potenciostato/potenciostato/entregable/fotos_en_laboratorio/IMG_20221214_155935435_MFNR.jpg

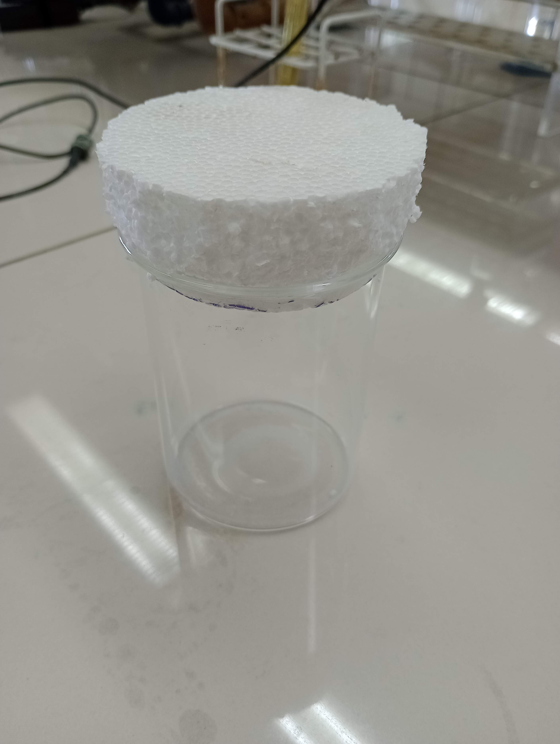
entregable/fotos_en_laboratorio/IMG_20221214_155935435_MFNR.jpg
