potenciostato/potenciostato/entregable/fotos_en_laboratorio/IMG_20221214_183304615_MFNR.jpg

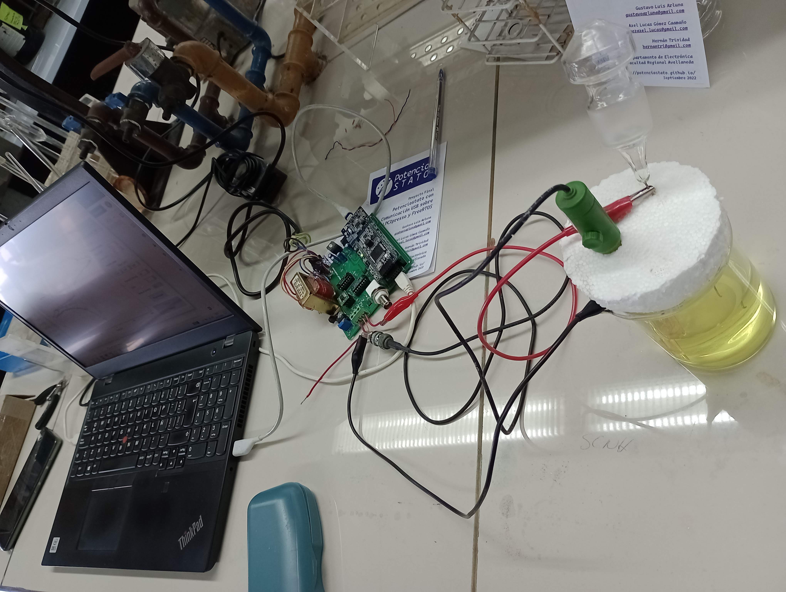
entregable/fotos_en_laboratorio/IMG_20221214_183304615_MFNR.jpg
