potenciostato/potenciostato/README.md

# Potenciostato con comunicación USB sobre LPCXpresso y FreeRTOS

Proyecto Final de la carrera Ingeniería Electrónica de la Universidad Tecnológica Nacional Facultad Regional Avellaneda <br>

El potenciostato es un dispositivo electrónico utilizado en la mayoría de los experimentos electroquímicos.<br>
Es un instrumento capaz de caracterizar la impedancia de una sustancia por medio de la medición de corriente y tensión.<br>

Integrantes del grupo:
- [Arluna, Gustavo Luis](mailto:gustavoarluna@gmail.com)<br>
- [Gómez Caamaño, Axel Lucas](mailto:gomezaxel.lucas@gmail.com)<br>
- [Trinidad, Hernán](mailto:hernantri@gmail.com)<br>

Para más info visitar la [Página Web Oficial](https://potenciostato.github.io) del proyecto
