potenciostato/potenciostato/qt/README.md

# Proyecto Final 2020 - UTN FRA/FRBA: Potenciostato

Mediante la técnica de voltamperometría, se miden sustratos (en principio líquidos) y se los categoriza en función de su respuesta voltamperométrica.

El código del sistema embebido está desarrollado sobre un kit de desarrollo NodeMCU con ESP32. El mismo cuenta con una aplicación web desde la cual se podrá medir y configurar el instrumento.

Integrantes del proyecto:
* Bernal Sebastián
* Gómez Axel
* Trinidad Hernán
* Gustavo Arluna

Links útiles:
* [Trello del proyecto](https://trello.com/b/e63ktGHQ/proyecto-final)
