potenciostato/potenciostato/workspace/periph_timer/example/readme.txt

timer (blinky) example

Example description
This examples uses the timers to generate a periodic interrupt and blink an
LED in the timer interrupt handler.

Special connection requirements
There are no special connection requirements for this example.

Build procedures:
Visit the LPCOpen quickstart guides at link "http://www.lpcware.com/content/project/lpcopen-platform-nxp-lpc-microcontrollers/lpcopen-v200-quickstart-guides"
to get started building LPCOpen projects.
