potenciostato/potenciostato/entregable/Anexo Potenciostato_paper_formato_IEEE_completo.pdf

# Anexo: Potenciostato con Comunicación USB sobre LPCXpresso y FreeRTOS

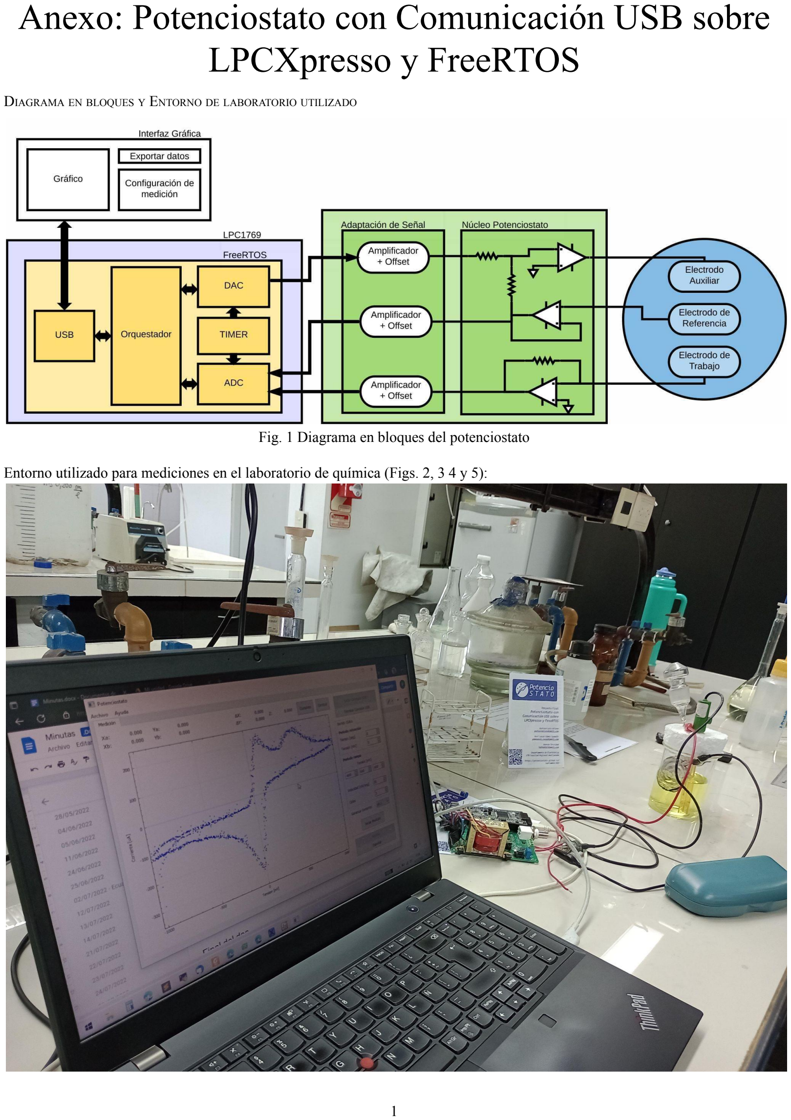
[picture p3: page 1]

DIAGRAMA EN BLOQUES Y ENTORNO DE LABORATORIO UTILIZADO

Fig. 1 Diagrama en bloques del potenciostato

Entorno utilizado para mediciones en el laboratorio de química (Figs. 2, 3 4 y 5):

Fig. 2 Potenciostato con software en Qt en pantalla, recipiente, sustancia y electrodos

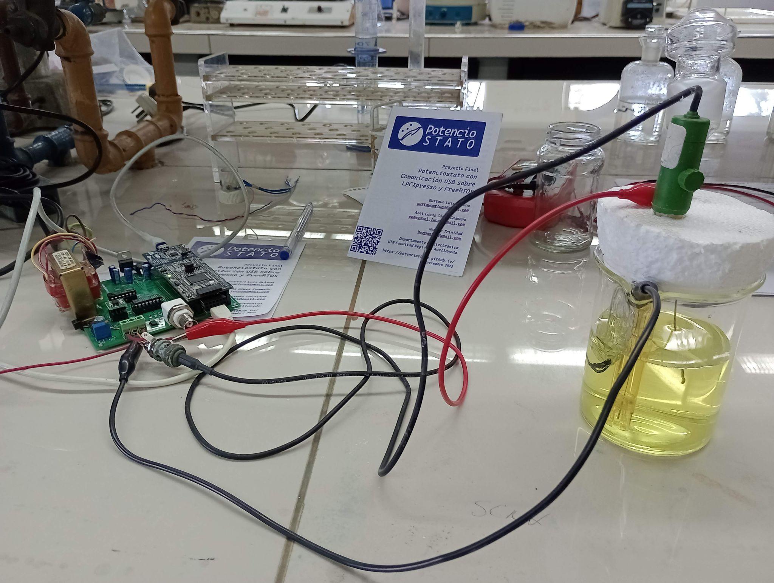
[picture p4: figure]

Fig. 3 Potenciostato con recipiente, sustancia y electrodos

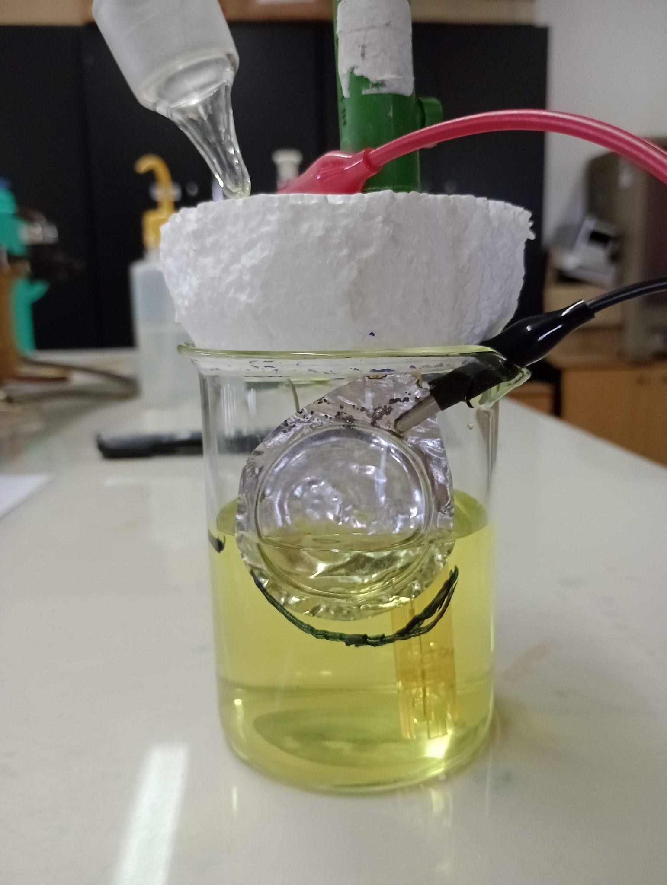
[picture p5: page 3]

Fig. 4 Recipiente con electrodos y sustancia

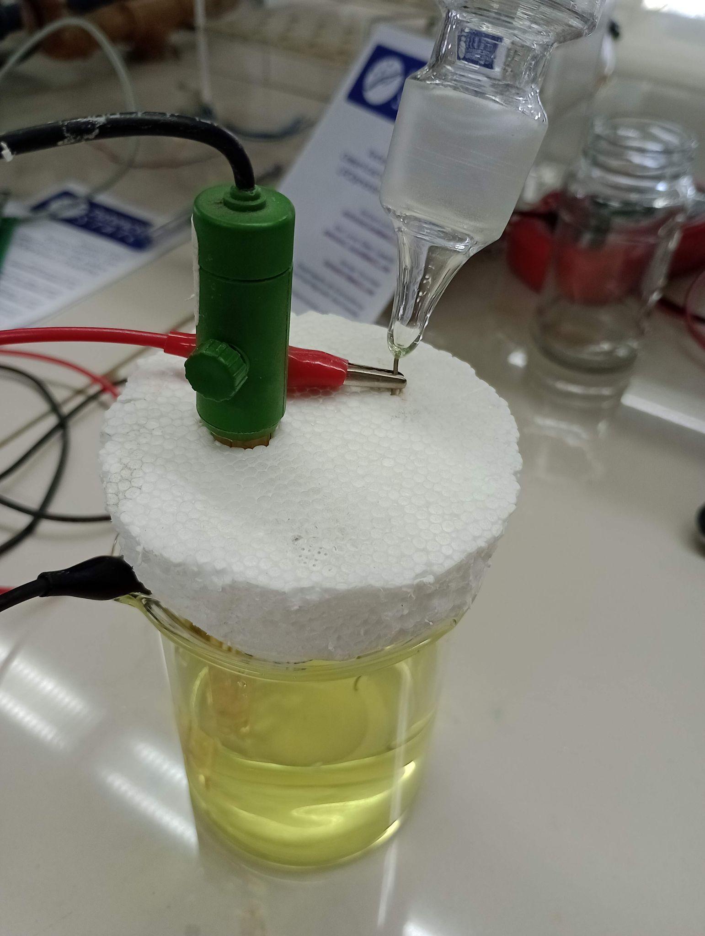
[picture p6: page 4]

Fig. 5 Conexión de los electrodos en recipiente

MEDICIÓN

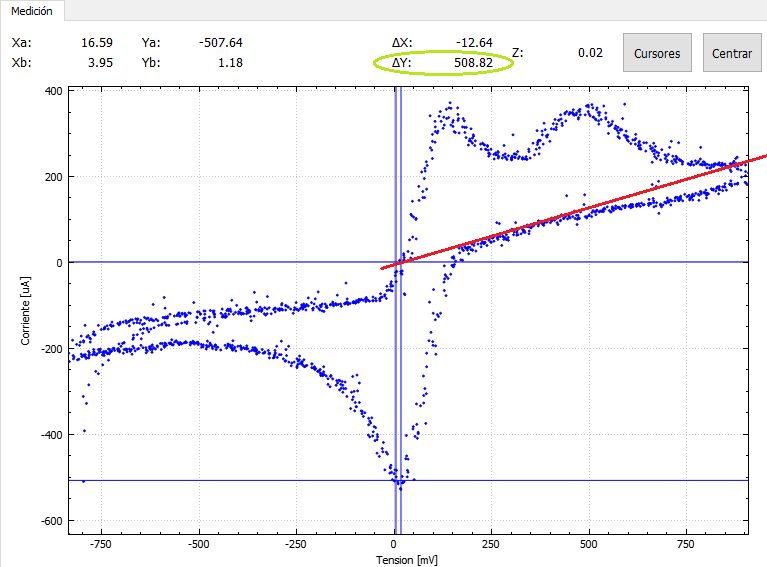
[picture p7: figure]

Fig. 6 Medición realizada por el potenciostato a la mezcla de Ferricianuro de Potasio (5mM), Ferrocianuro de Potasio (5mM) y Cloruro de Potasio (100mM) en un recipiente con electrodos de posición calibrada

HOJA DE CÁLCULOS

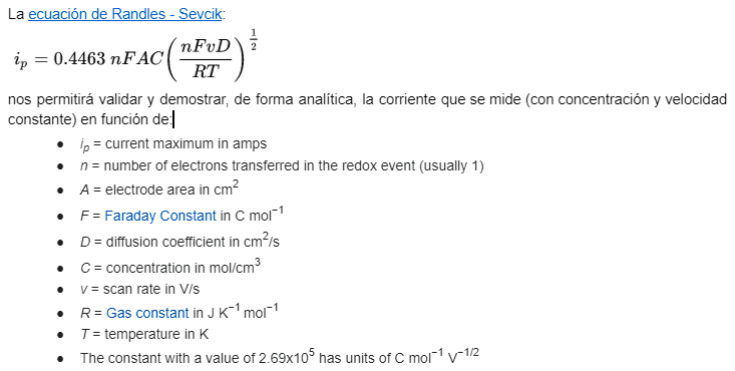
[picture p8: figure]

Ecuación Randles-Sevcik

Ecuación Randles-Sevcik simplificada mediante la cual se puede calcular la constante de difusión:

Datos a utilizar para la ecuación:

Radio electrodo | 0,05 | cm
Altura electrodo | 2 | cm
n (electrones transferidos) | 1 | sin unidad
F = Faraday Constant in C mol−1 | 96485,33212 | C * mol^(−1)
A = electrode area in cm2 | 0,6361725124 | cm^2
C = concentration in mol/cm3 | 0,005 | M
ν = scan rate in V/s | 0,05 | V/s
R = Gas constant in J K−1 mol−1 | 8,31432 | J*K^(-1)*mol^(-1)
T = temperature in K | 300 | K

Nota: las constantes de Faraday y de los gases junto con la temperatura (25°C ó 300K) están incluídas en la ecuación simplificada a utilizar.

Corriente medida:

ip | 0,508 | mA

Resultado obtenido:

D | 7,11E-06 | cm^2 / s

Resultado ideal (se puede demostrar teóricamente):

D = diffusion coefficient in cm2/s | 0,000007 | cm^2 / s

Constante de difusión obtenida: 7,11.E-06
Constante de difusión verdadera: 7.E-06 => Er = 1,6%

IEC 61010:2010 - REQUERIMIENTOS PARA EQUIPAMIENTO ELÉCTRICO PARA MEDICIÓN, CONTROL Y USO EN LABORATORIOS
Marco Regulatorio, Legal y Normativo
Todos los aparatos eléctricos de uso comercial, doméstico, accesibles al público en general, deben cumplir con los requisitos de la Resolución 162/2018, que exige que dichos productos cumplan con normas de seguridad eléctrica y posean cierta información que permita hacer un uso seguro del mismo, de manera de evitar accidentes, pérdidas materiales, económicas y humanas.

Los productos dentro del alcance de la Resolución 162/2018 son todos aquellos que tengan una tensión nominal de hasta 1.000V en valor eficaz de corriente alterna senoidal o hasta 1.500V en corriente continua. A estos aparatos se los denomina “equipamientos eléctricos de baja tensión” y deben ser ensayados bajo normas IRAM o IEC. En la mayoría de los casos, se utilizan las normas internacionales IEC debido a que las normas locales IRAM no han sido actualizadas en los últimos años.

Sin embargo, hay determinados productos que están exentos de cumplir obligatoriamente con los requerimientos de la Resolución 162/2018. Los artículos 12 y 13 de la Resolución establecen las condiciones para considerar que un aparato eléctrico queda exento del cumplimiento de la misma. Una de esas condiciones es que el “equipamiento que por sus características técnicas sea de uso profesional, o por ser destinado a incorporarse a procesos en los que serán operados por personal capacitado en materia de seguridad eléctrica, o bien siendo estos bienes instalados únicamente por personal idóneo y destinados a usos profesionales por parte de operadores con conocimientos en dicha materia” puede comercializarse respaldado por una declaración jurada del fabricante nacional o importador.

En el caso del potenciostato, se considera que está destinado a ser utilizado por personal capacitado de laboratorio que se encuentra fuera del alcance del acceso al público en general.

Por tal motivo, no es obligación ensayar el potenciostato bajo las normas de seguridad para comercializarlo en el país.

Sin embargo, siempre es posible ensayar de manera voluntaria el potenciostato bajo la norma IEC: 61010-1:2010, en especial si se fabrica con fines de exportación, ya que en otros países la certificación podría ser obligatoria.

### L7805GND

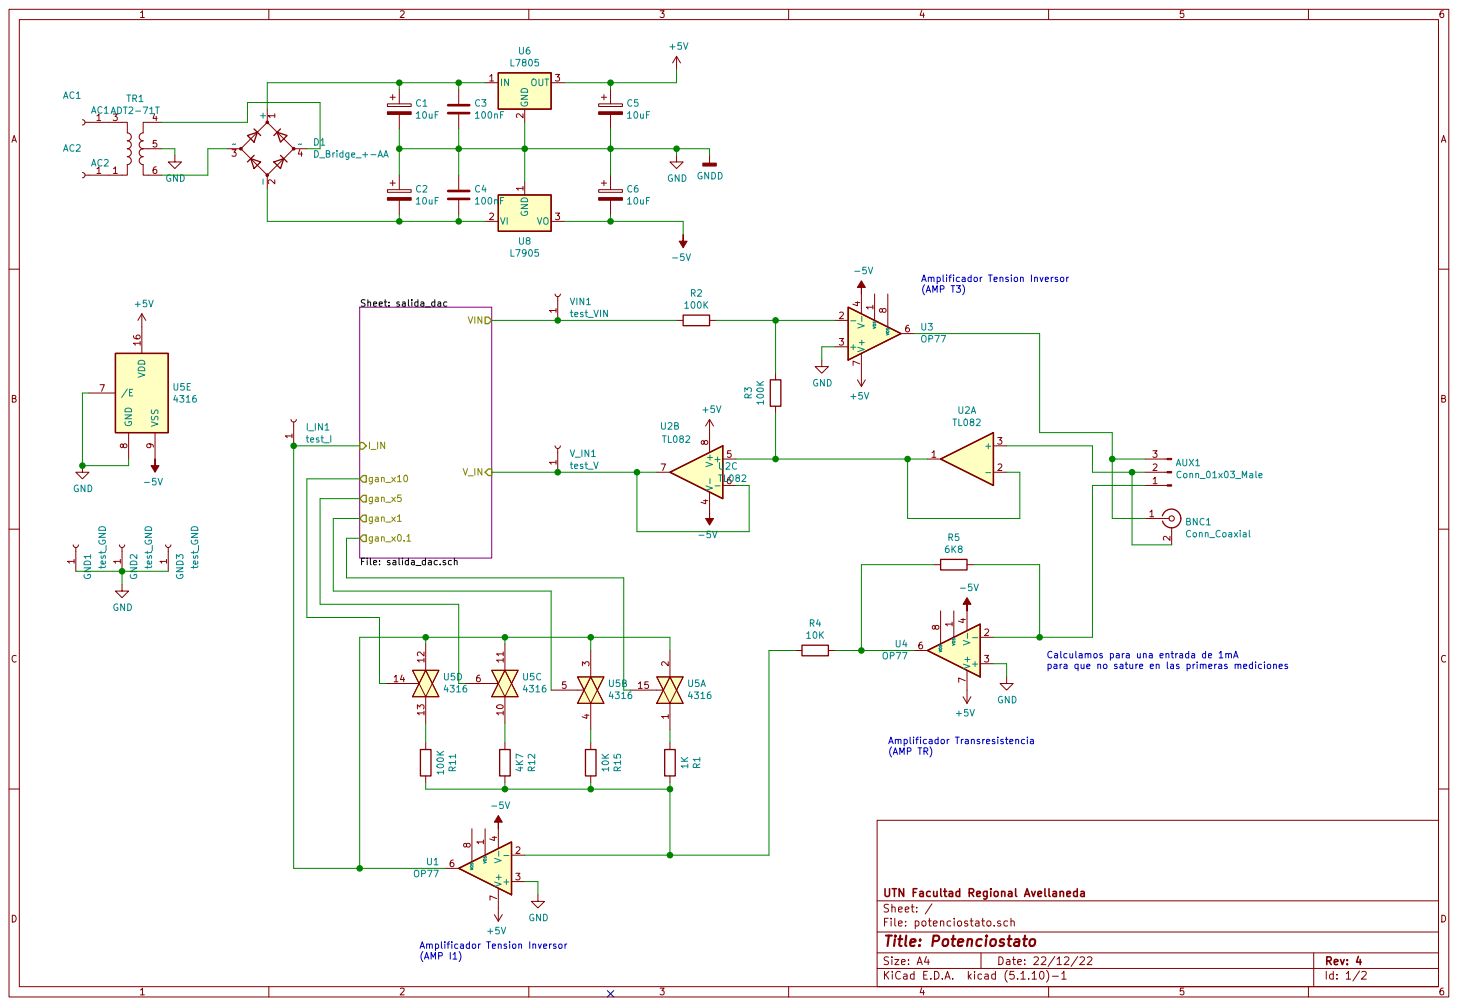
[picture p9: page 8]

Calculamos para una entrada de 1mA
para que no sature en las primeras mediciones

File: potenciostato.sch Sheet: / UTN Facultad Regional Avellaneda

### TL064 R9

# (AMP I2) Salida DAC uC de 0 a 3.3V

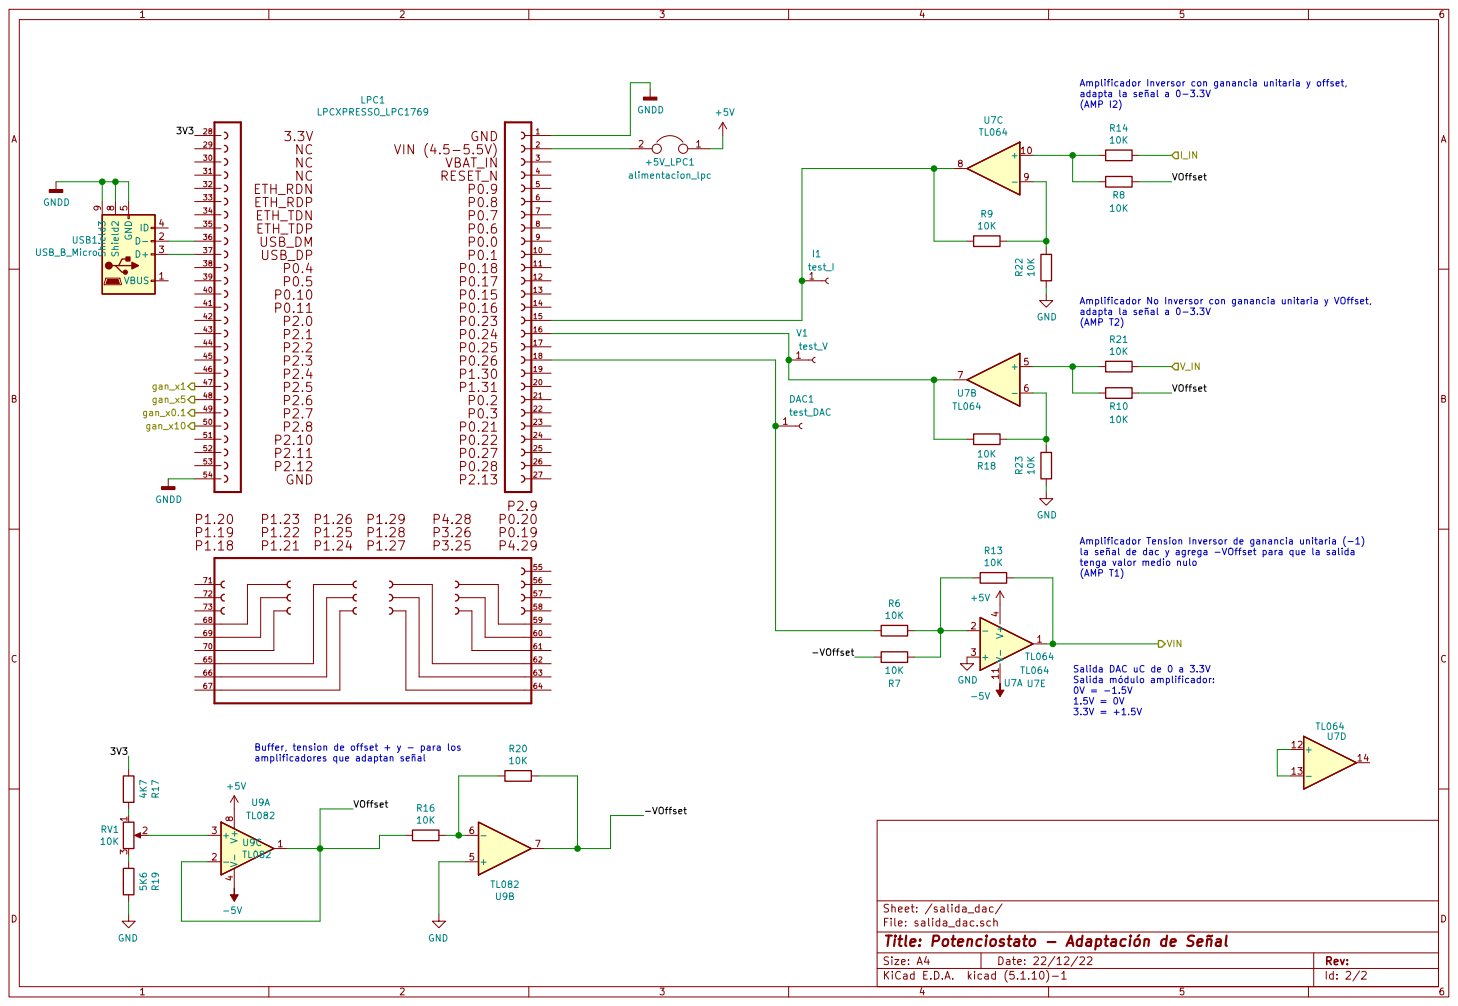
[picture p10: page 9]

Amplificador Inversor con ganancia unitaria y offset,
adapta la señal a 0-3.3V

Amplificador No Inversor con ganancia unitaria y VOffset,
(AMP T2)

Amplificador Tension Inversor de ganancia unitaria (-1)

la señal de dac y agrega -VOffset para que la salida
tenga valor medio nulo
(AMP T1)

Buffer, tension de offset + y - para los
amplificadores que adaptan señal

File: salida_dac.sch
Id: 2/2 Title: Potenciostato - Adaptación de Señal

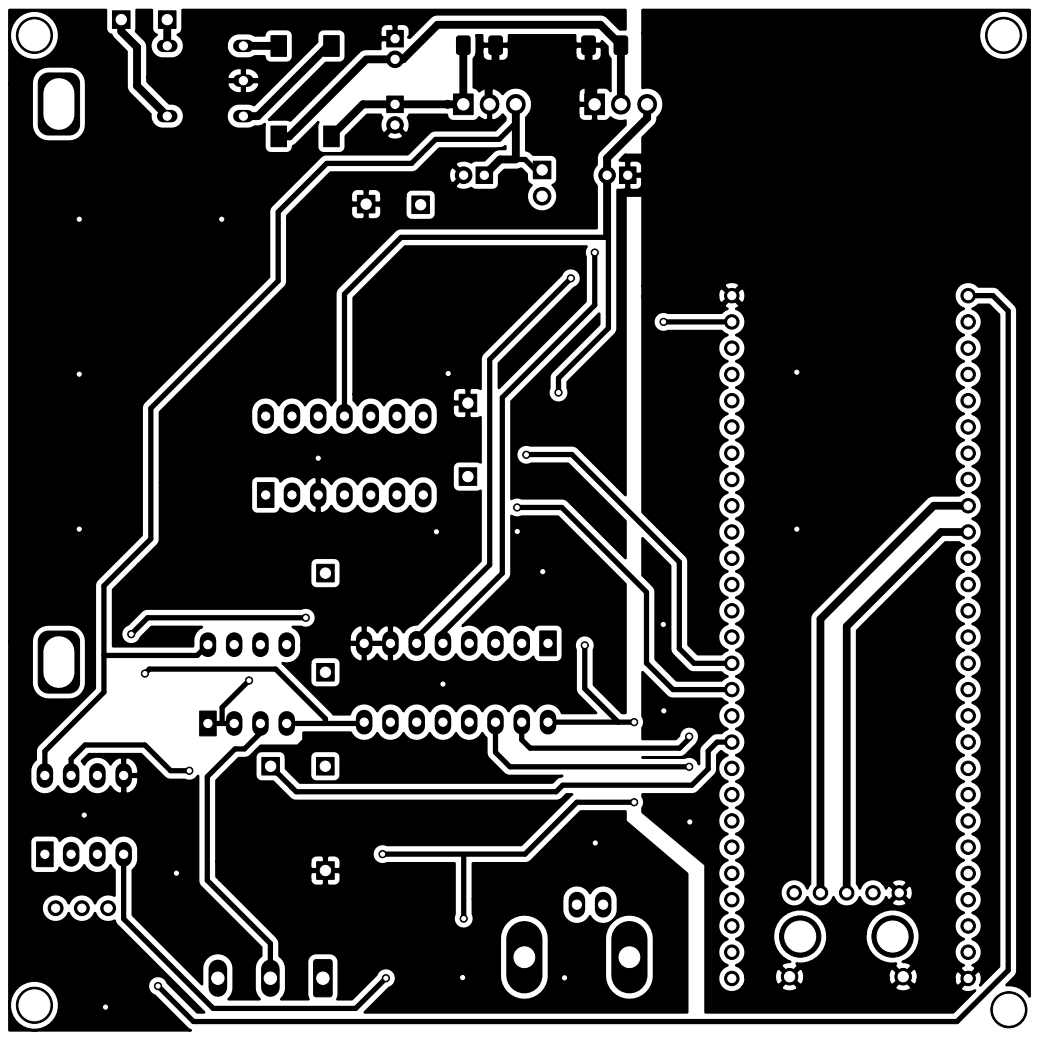
[picture p11: page 10]

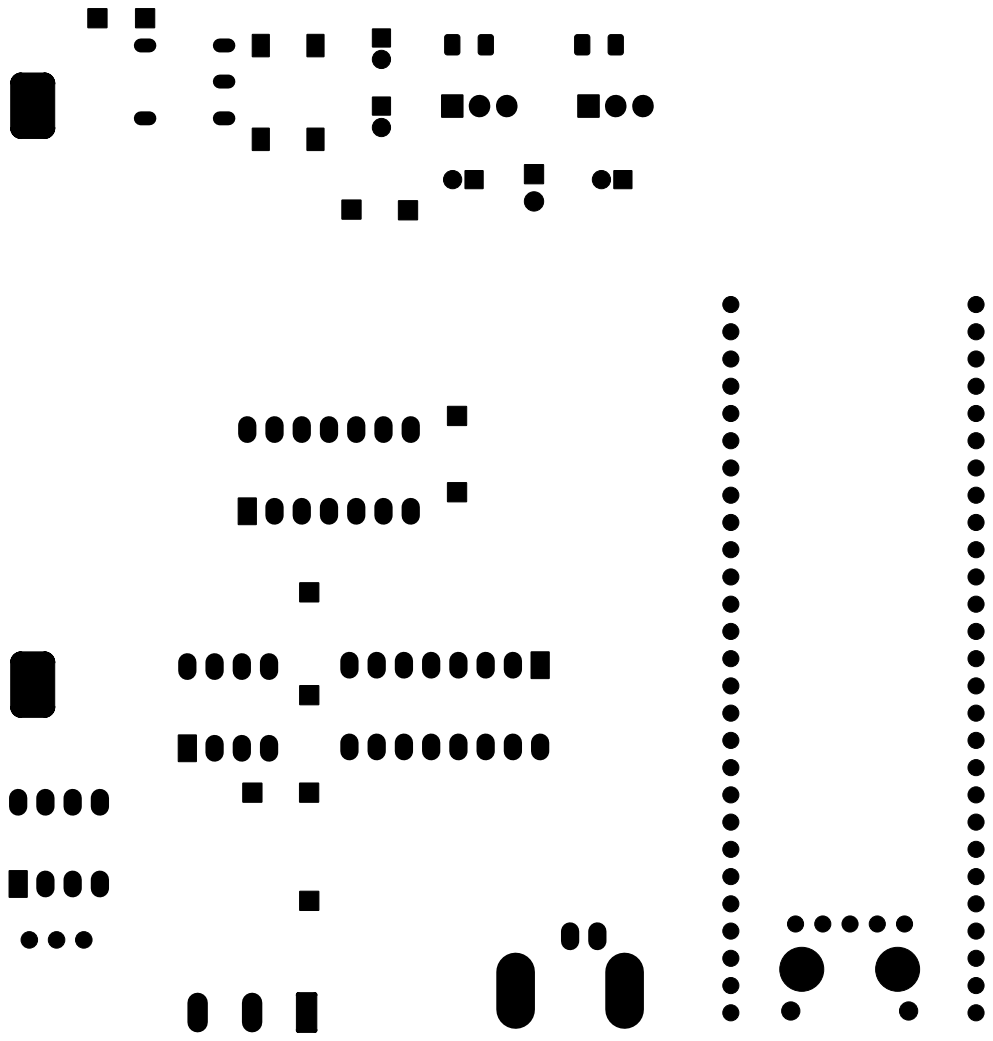
[picture p12: page 11]

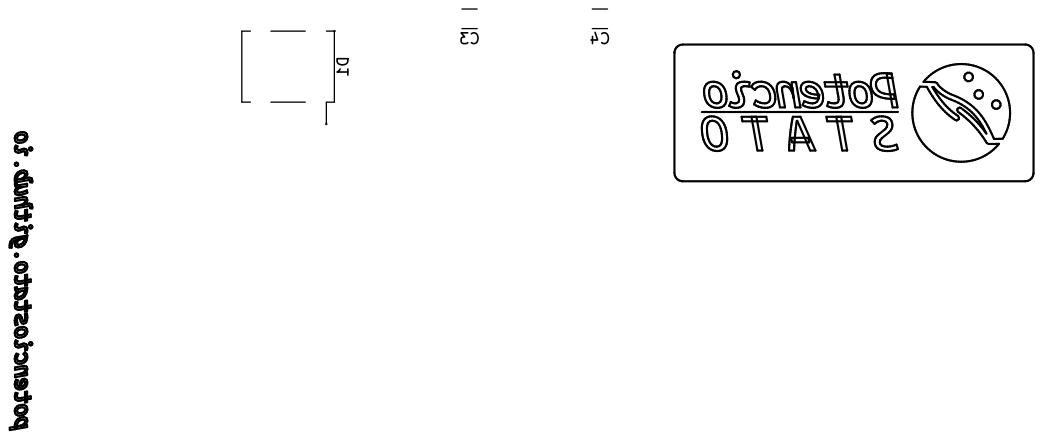
[picture p13: page 12]

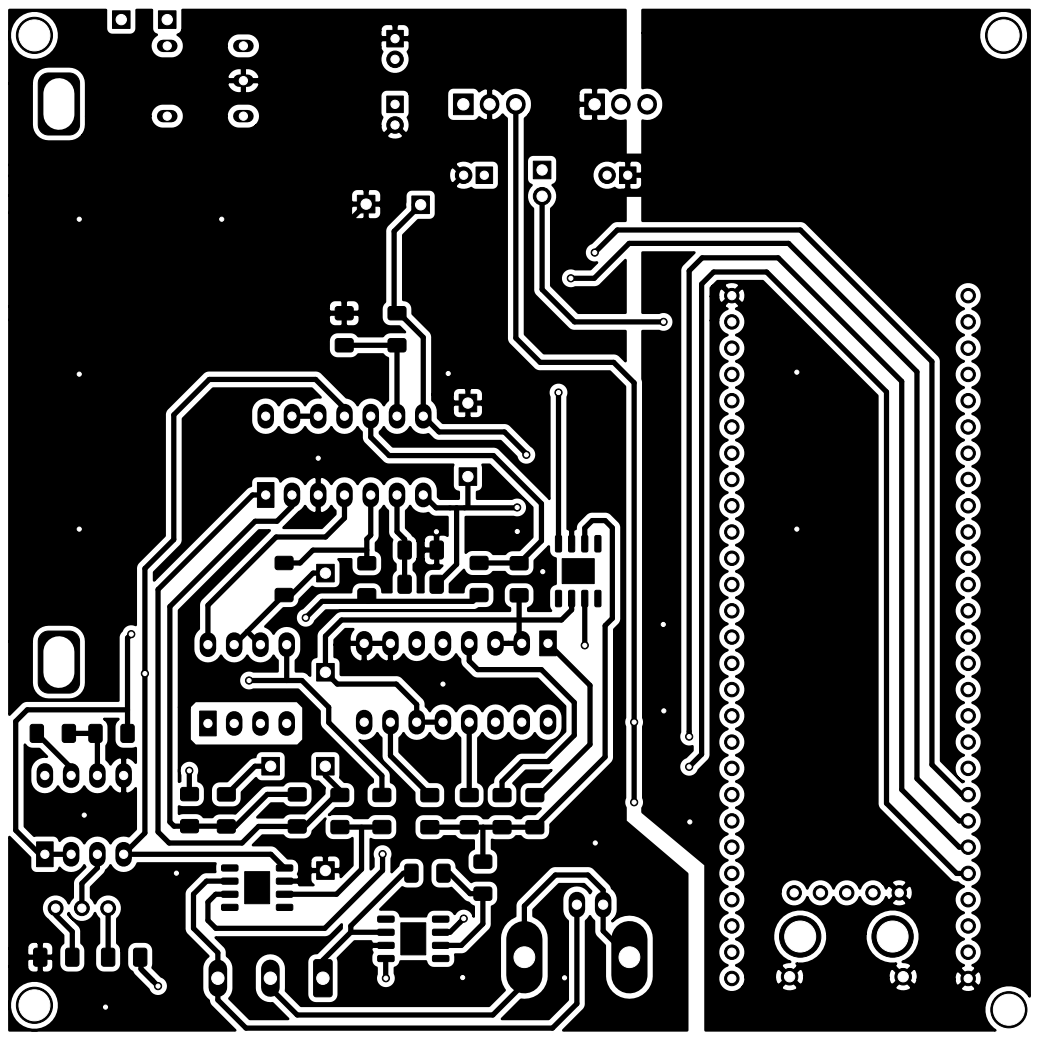
[picture p14: page 13]

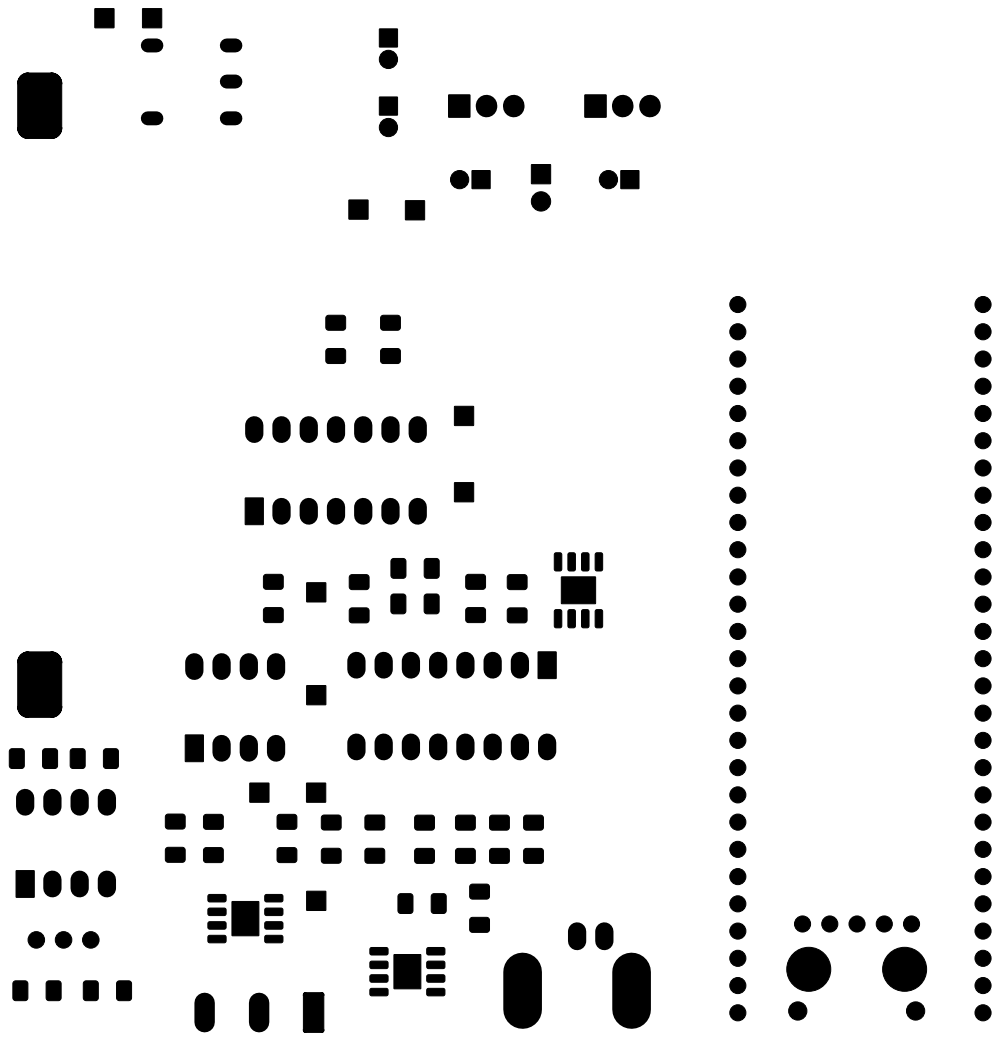
[picture p15: page 14]

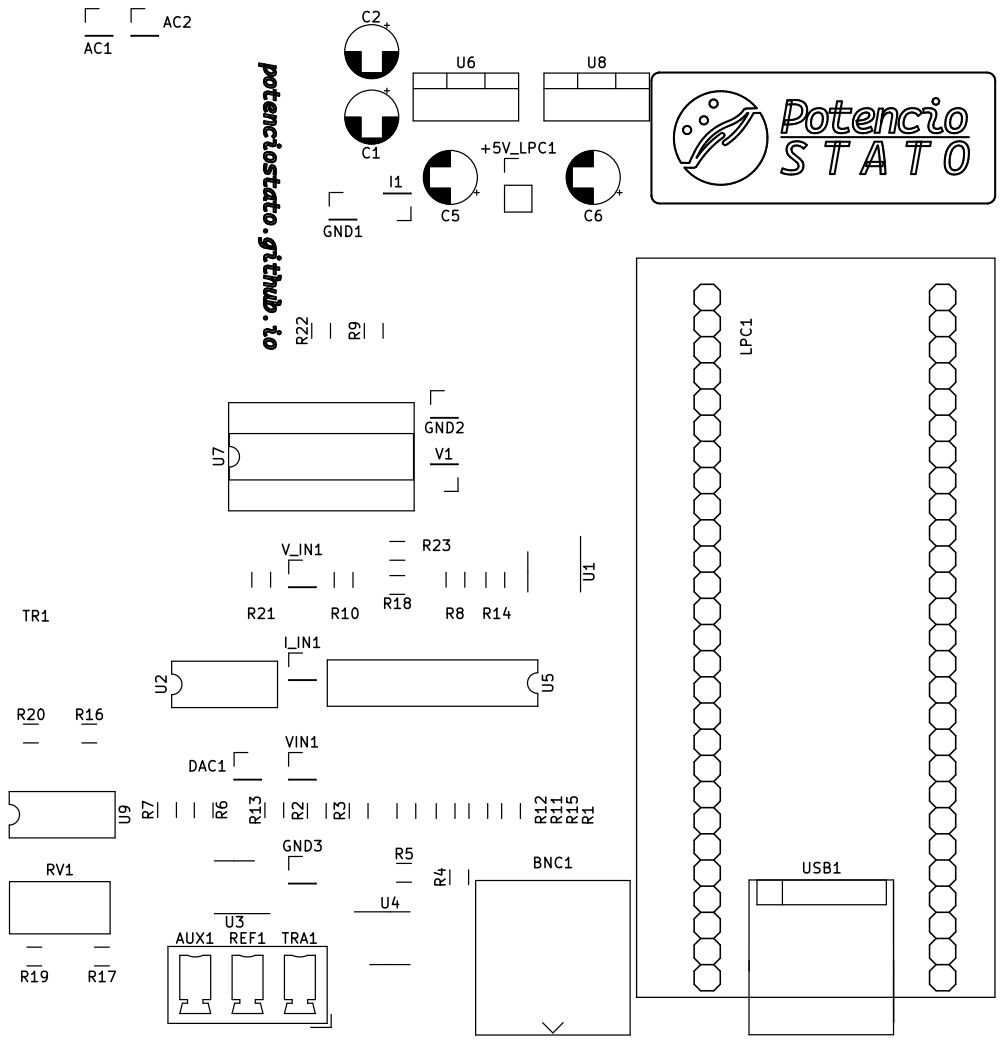
[picture p16: page 15]
