potenciostato/potenciostato/entregable/fotos_en_laboratorio/IMG_20221214_175959559_MFNR.jpg

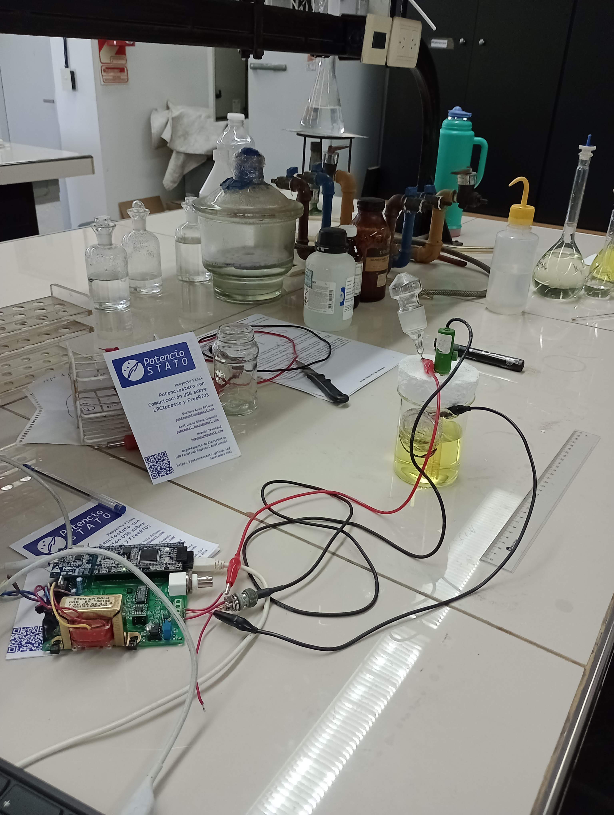
entregable/fotos_en_laboratorio/IMG_20221214_175959559_MFNR.jpg
