potenciostato/potenciostato/entregable/fotos_en_laboratorio/IMG_20221214_180008440_MFNR.jpg

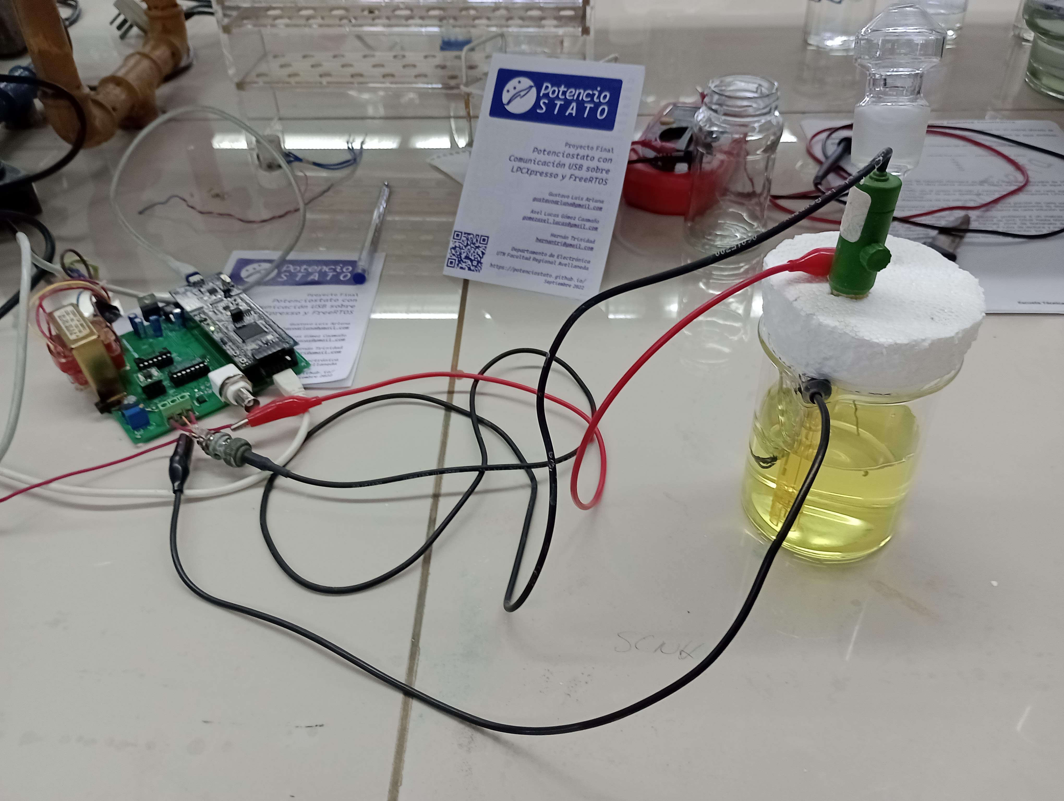
entregable/fotos_en_laboratorio/IMG_20221214_180008440_MFNR.jpg
