potenciostato/potenciostato/entregable/fotos_en_laboratorio/IMG_20221214_180010219_MFNR.jpg

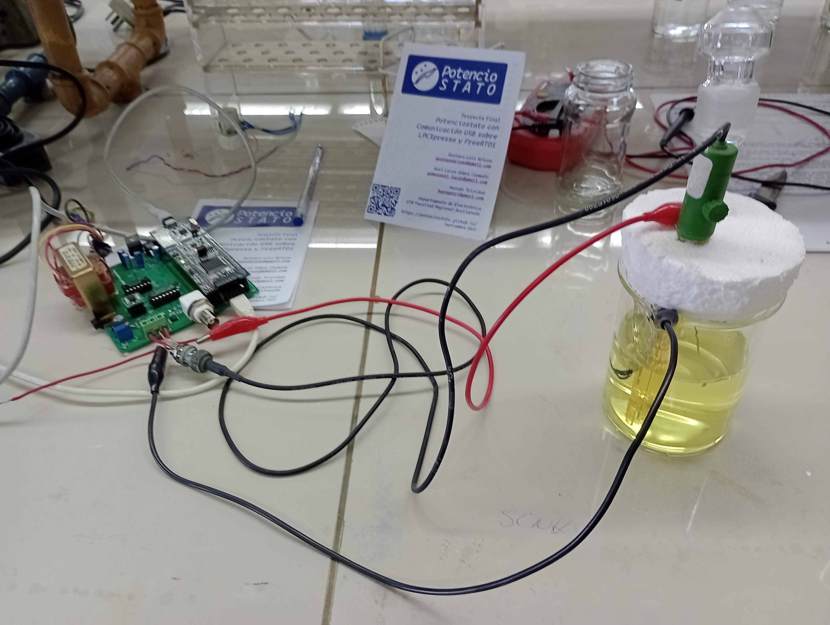
entregable/fotos_en_laboratorio/IMG_20221214_180010219_MFNR.jpg
