potenciostato/potenciostato/entregable/fotos_en_laboratorio/IMG_20221214_184859711.jpg

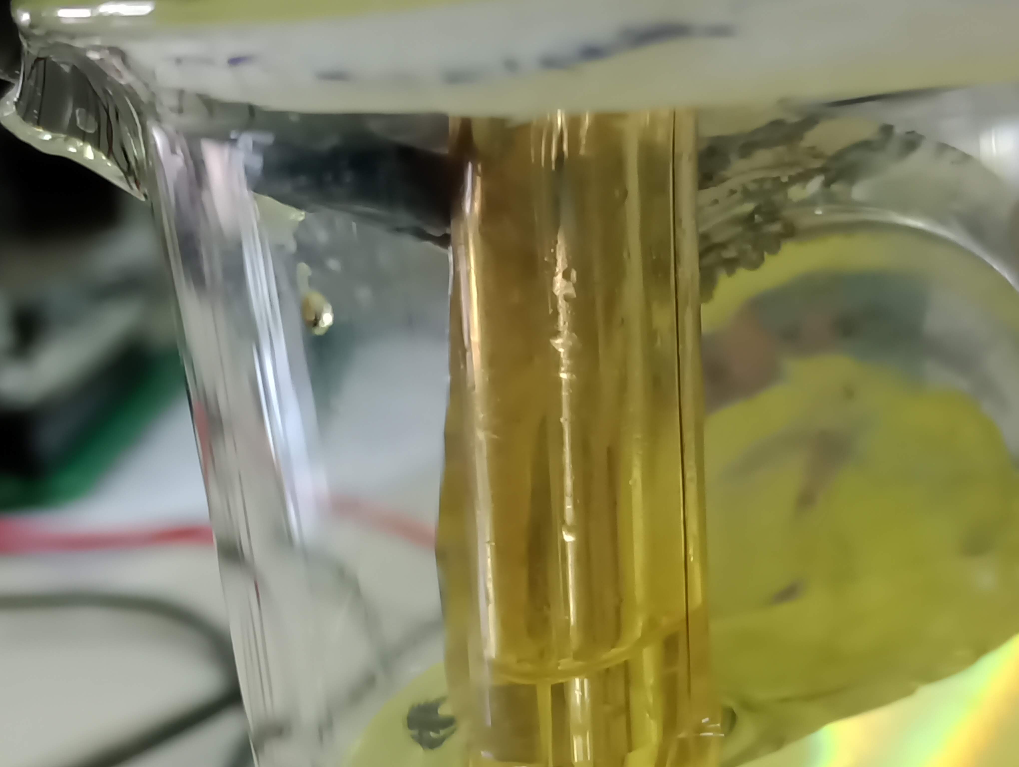
entregable/fotos_en_laboratorio/IMG_20221214_184859711.jpg
