potenciostato/potenciostato/entregable/fotos_en_laboratorio/IMG_20221214_184909411.jpg

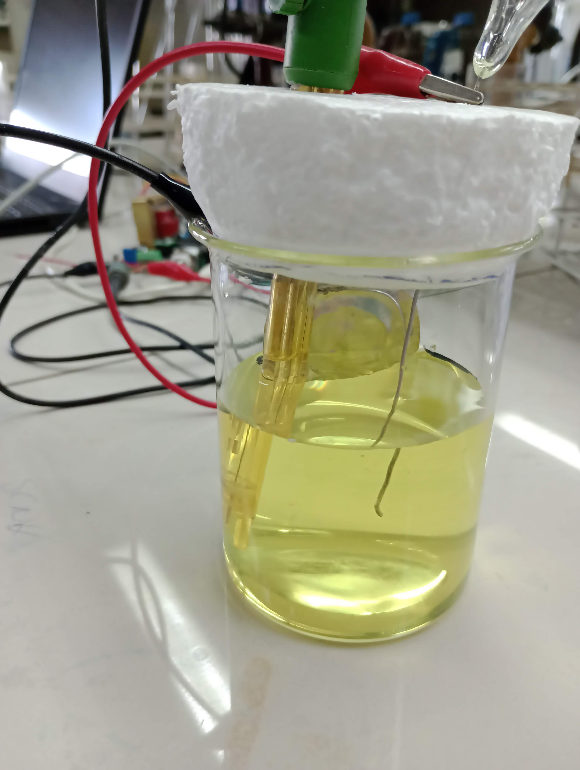
entregable/fotos_en_laboratorio/IMG_20221214_184909411.jpg
