potenciostato/potenciostato/ltspice/20200818_140919.jpg

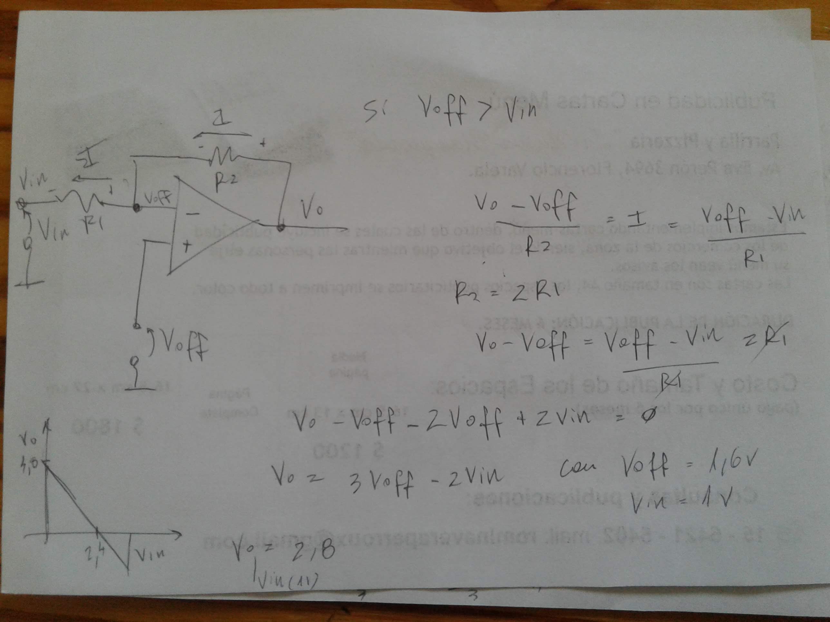
ltspice/20200818_140919.jpg
