potenciostato/potenciostato/ltspice/20200818_140930.jpg

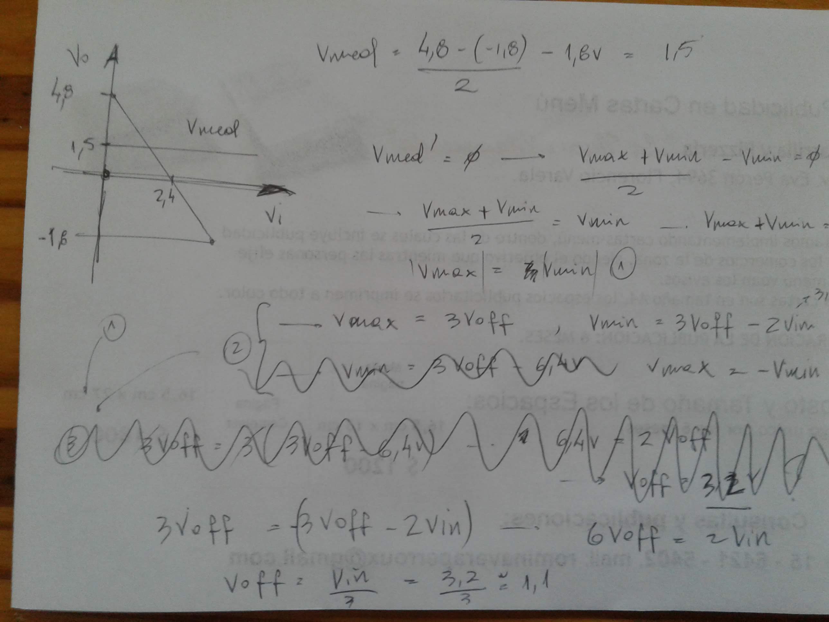
ltspice/20200818_140930.jpg
