potenciostato/potenciostato/ltspice/20200818_142315.jpg

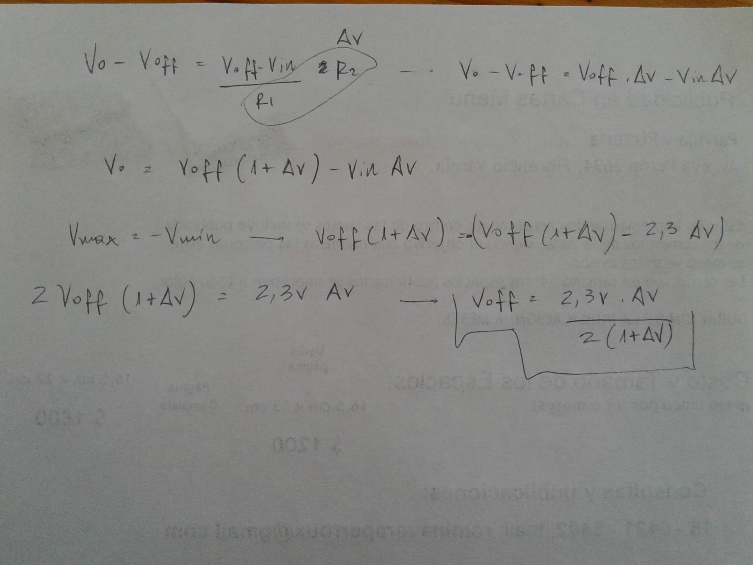
ltspice/20200818_142315.jpg
