potenciostato/potenciostato/logo/logo_potencio_kicad_web_invertida.dxf

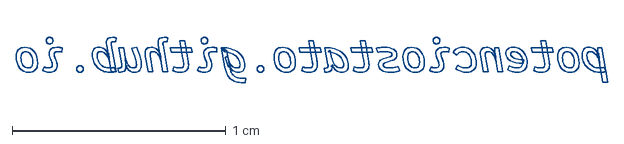
[picture p48: CAD file, 2022-11-13]
logo/logo_potencio_kicad_web_invertida.dxf
2.77 x 0.212 cm
