potenciostato/potenciostato/logo/logo_potencio_kicad_web.dxf

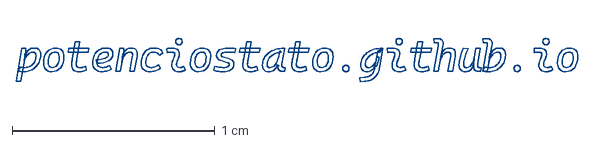
[picture p49: CAD file, 2022-11-13]
logo/logo_potencio_kicad_web.dxf
2.77 x 0.212 cm
