potenciostato/potenciostato/logo/logo_potencio_kicad_invertido.dxf

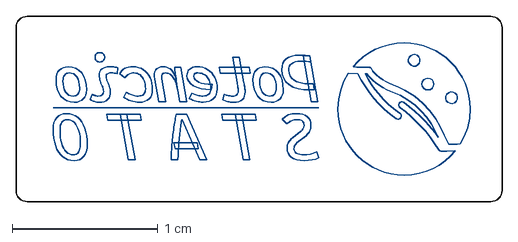
[picture p50: CAD file, 2022-11-11]
logo/logo_potencio_kicad_invertido.dxf
3.34 x 1.27 cm
