potenciostato/potenciostato/logo/qr.dxf

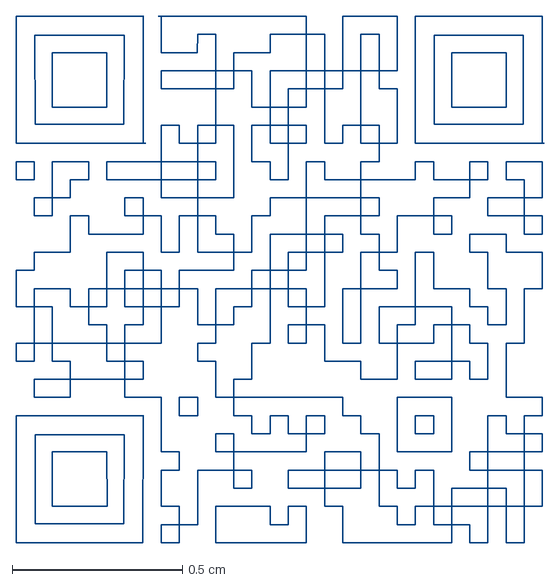
[picture p51: CAD file, 2022-11-11]
logo/qr.dxf
1.55 x 1.55 cm
