potenciostato/potenciostato/logo/logo_potencio.dxf

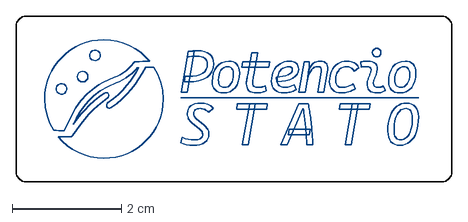
[picture p52: CAD file, 2022-11-11]
logo/logo_potencio.dxf
7.99 x 3.04 cm
