potenciostato/potenciostato/csv/med_2022.12.14-18_26_06_recalibrado_x0.1.csv

Tension | Corriente
27.515 | -75.220
26.027 | -73.056
-835.489 | -632.593
-803.498 | -633.674
-796.803 | -510.295
-794.571 | -392.327
-789.363 | -328.472
-797.547 | -312.238
-783.411 | -285.182
-758.861 | -259.206
-765.557 | -253.796
-747.701 | -238.643
-732.822 | -227.820
-743.981 | -216.999
-744.725 | -207.257
-729.846 | -202.929
-718.687 | -199.683
-700.831 | -195.353
-692.648 | -186.695
-706.039 | -189.941
-693.392 | -187.777
-668.840 | -169.378
-662.888 | -131.499
-668.840 | -175.872
-659.168 | -168.296
-645.033 | -165.049
-629.410 | -161.802
-650.985 | -156.391
-633.129 | -156.391
-624.202 | -155.309
-616.018 | -152.062
-604.115 | -146.650
-595.188 | -143.404
-596.675 | -145.568
-578.076 | -146.650
-584.772 | -145.568
-584.028 | -146.650
-558.733 | -144.486
-555.013 | -143.404
-531.206 | -137.992
-537.158 | -139.074
-531.950 | -142.321
-545.341 | -141.239
-505.167 | -128.252
-514.095 | -93.619
-508.887 | -140.157
-487.312 | -134.745
-485.080 | -129.334
-488.799 | -130.416
-472.432 | -139.074
-473.921 | -127.169
-460.528 | -127.169
-439.698 | -122.840
-438.954 | -127.169
-441.186 | -127.169
-430.026 | -126.087
-432.258 | -123.923
-424.074 | -120.676
-412.171 | -120.676
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
