potenciostato/potenciostato/csv/med_2022.12.14-18_26_06_recalibrado_x1.csv

Tension | Corriente
27.515 | -7.522
26.027 | -7.306
-835.489 | -63.259
-803.498 | -63.367
-796.803 | -51.030
-794.571 | -39.233
-789.363 | -32.847
-797.547 | -31.224
-783.411 | -28.518
-758.861 | -25.921
-765.557 | -25.380
-747.701 | -23.864
-732.822 | -22.782
-743.981 | -21.700
-744.725 | -20.726
-729.846 | -20.293
-718.687 | -19.968
-700.831 | -19.535
-692.648 | -18.669
-706.039 | -18.994
-693.392 | -18.778
-668.840 | -16.938
-662.888 | -13.150
-668.840 | -17.587
-659.168 | -16.830
-645.033 | -16.505
-629.410 | -16.180
-650.985 | -15.639
-633.129 | -15.639
-624.202 | -15.531
-616.018 | -15.206
-604.115 | -14.665
-595.188 | -14.340
-596.675 | -14.557
-578.076 | -14.665
-584.772 | -14.557
-584.028 | -14.665
-558.733 | -14.449
-555.013 | -14.340
-531.206 | -13.799
-537.158 | -13.907
-531.950 | -14.232
-545.341 | -14.124
-505.167 | -12.825
-514.095 | -9.362
-508.887 | -14.016
-487.312 | -13.475
-485.080 | -12.933
-488.799 | -13.042
-472.432 | -13.907
-473.921 | -12.717
-460.528 | -12.717
-439.698 | -12.284
-438.954 | -12.717
-441.186 | -12.717
-430.026 | -12.609
-432.258 | -12.392
-424.074 | -12.068
-412.171 | -12.068
-399.523 | -11.959
-392.084 | -12.068
-386.132 | -11.959
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
