potenciostato/potenciostato/kicadv2/potencio_IMPRIMIR.pdf

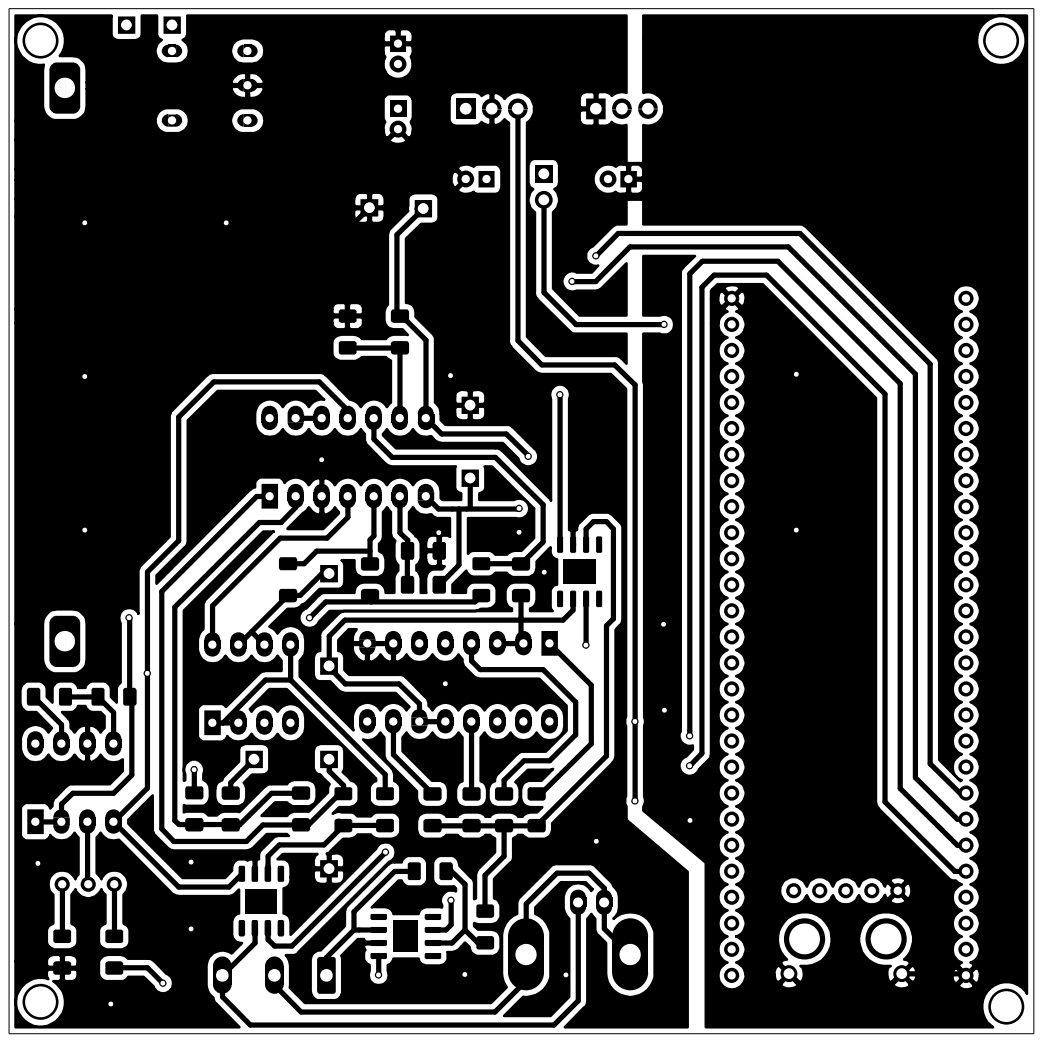
[picture p53: page 1]

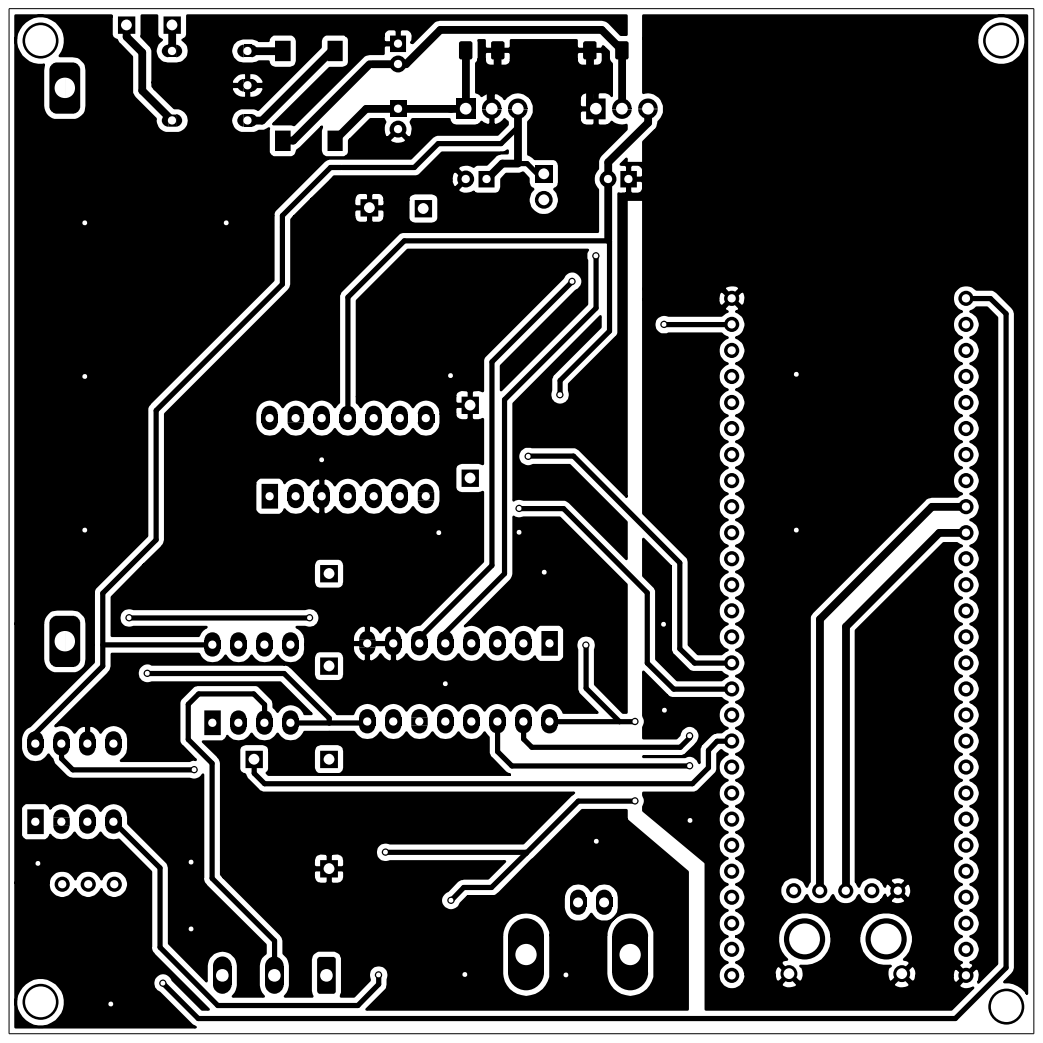
[picture p54: page 2]
