potenciostato/potenciostato/logo/Potenciostato.pdf

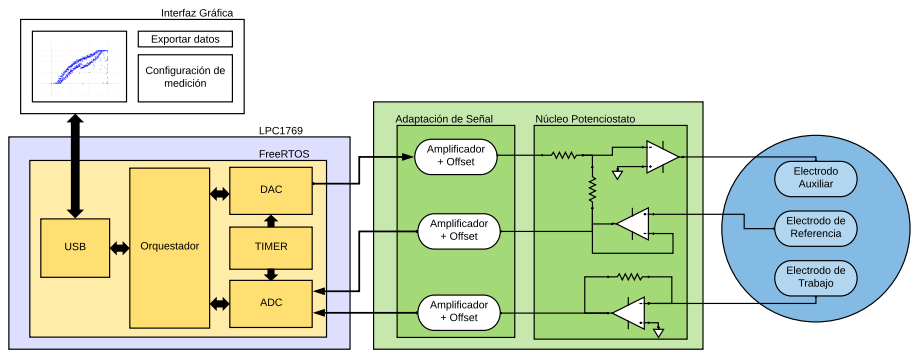
[picture p55: page 1]
fic; fig; ció; dició; plific; Ele; xilia; cia; ajo; cle; cio; s Interfaz Gráfic; TIM
