potenciostato/potenciostato/kicad_reducido/potenciostato-B_Cu.pdf

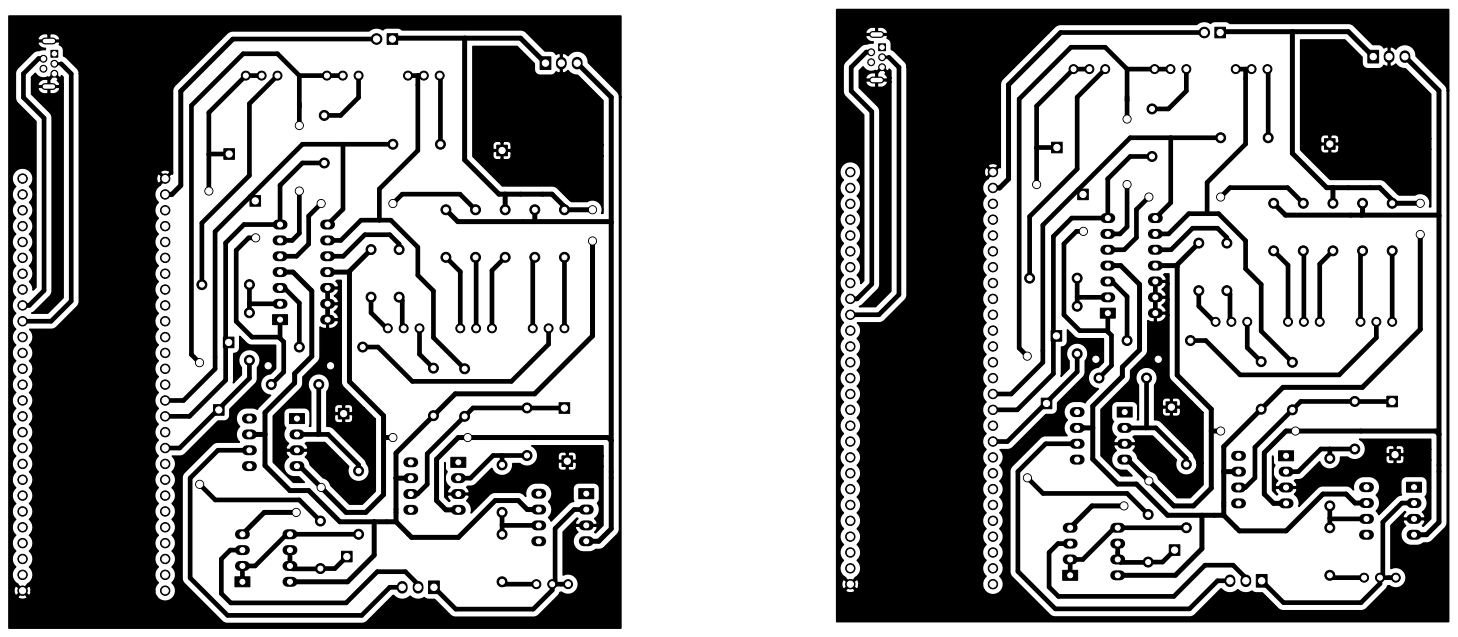
[picture p60: page 1]
