potenciostato/potenciostato/kicad_reducido/potenciostato_v0.pdf

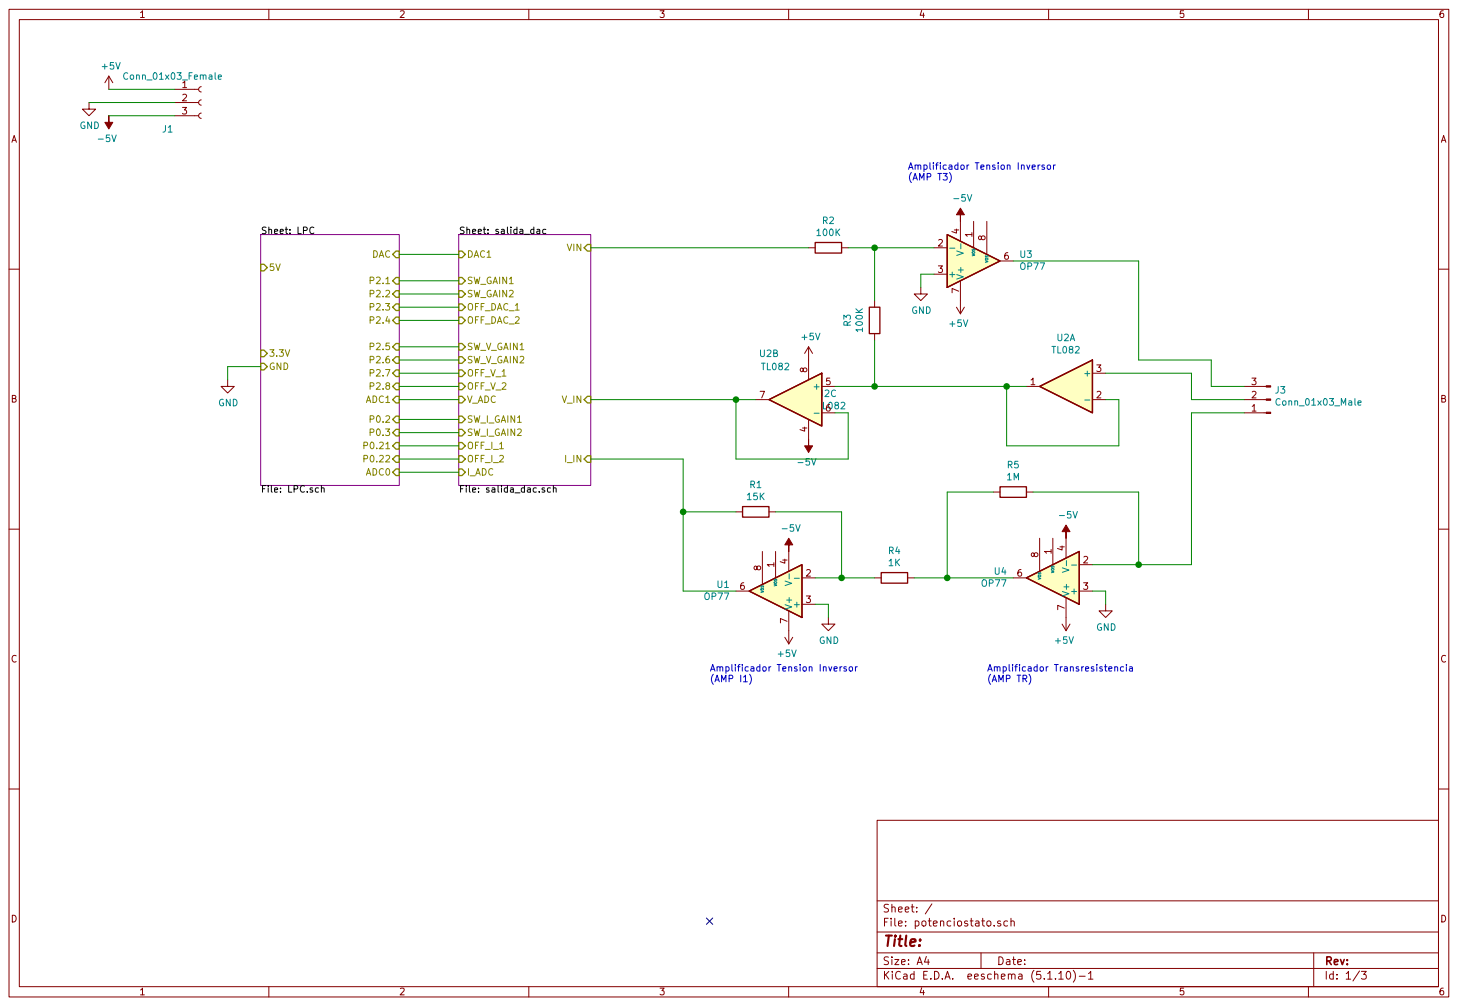
[picture p61: page 1]

File: LPC.sch GND

File: potenciostato.sch Sheet: /
Id: 1/3 Title:

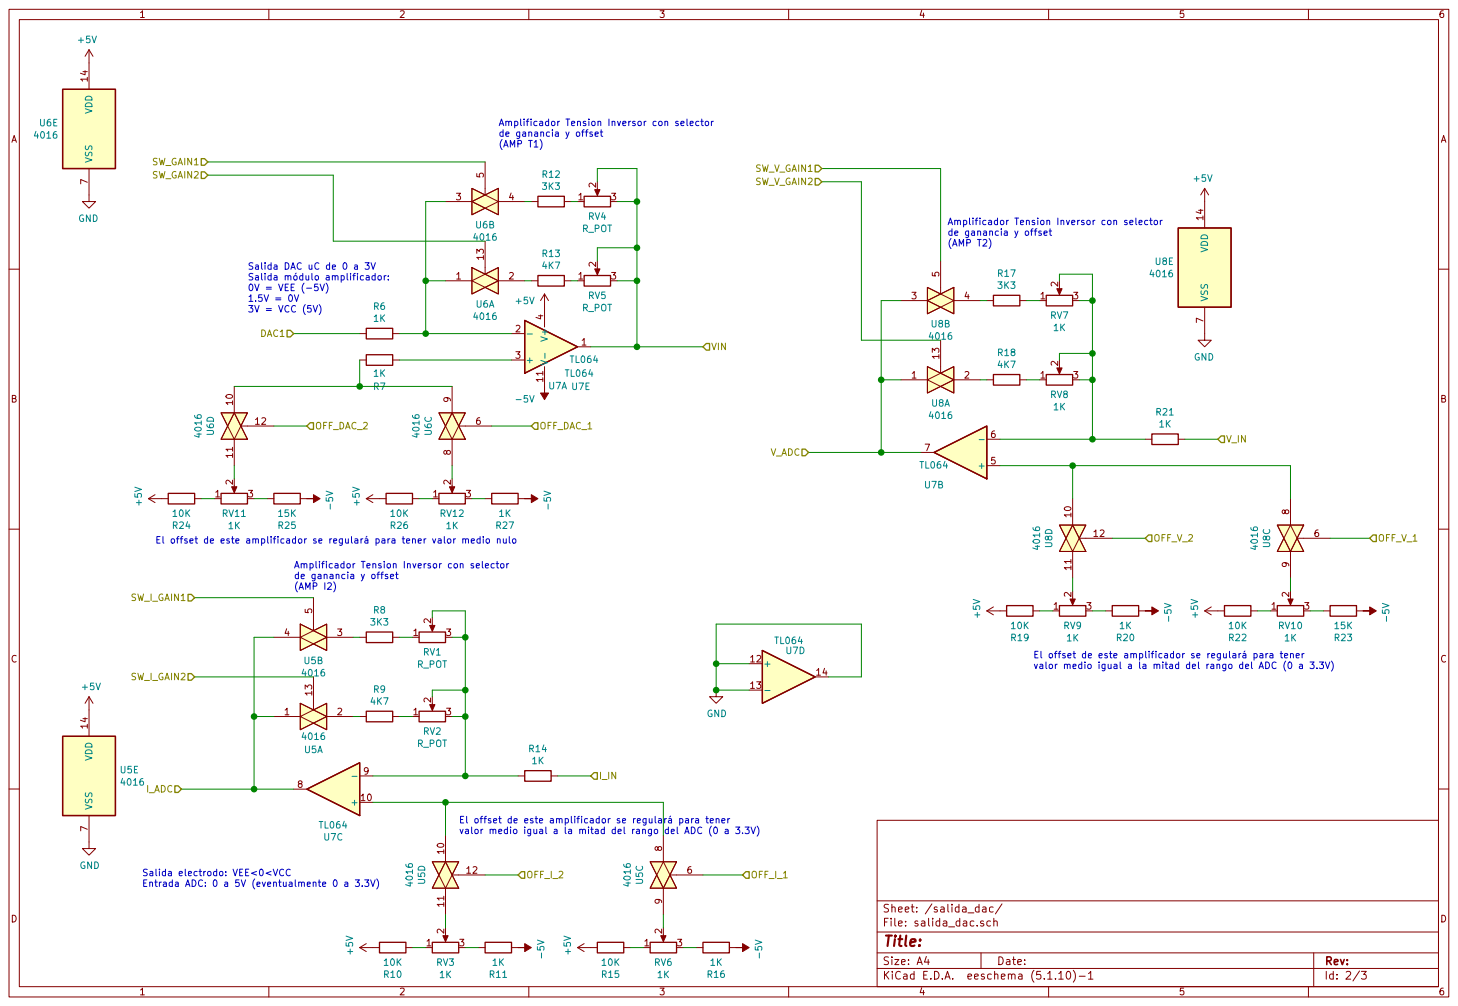
[picture p62: page 2]

Amplificador Tension Inversor con selector
de ganancia y offset
(AMP T1)

(AMP T2)

valor medio igual a la mitad del rango del ADC (0 a 3.3V) Salida DAC uC de 0 a 3V
Salida módulo amplificador:
0V = VEE (-5V) 1.5V = 0V

El offset de este amplificador se regulará para tener valor medio nulo

(AMP I2)

El offset de este amplificador se regulará para tener

valor medio igual a la mitad del rango del ADC (0 a 3.3V)

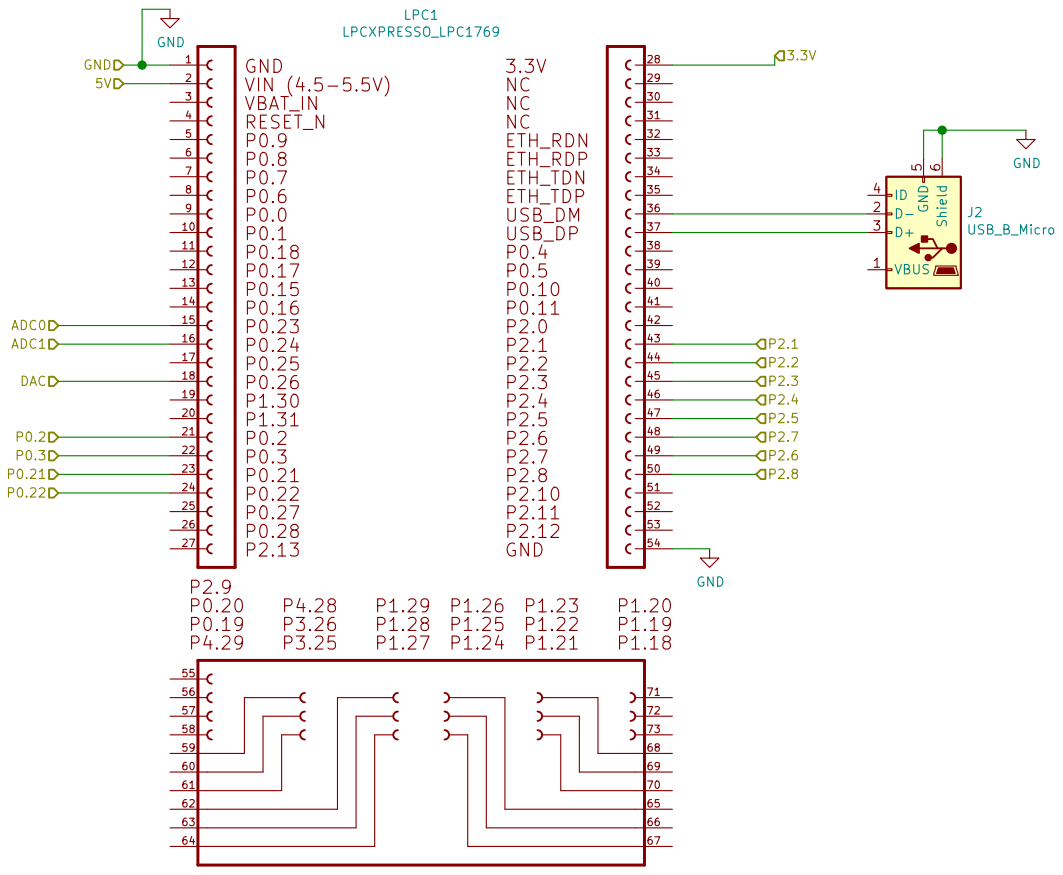
[picture p63: page 3]

Id: 3/3 Title: File: LPC.sch Sheet: /LPC/
