potenciostato/potenciostato/ltspice/Salida DAC/amplificador_pruebas_off.asc

R1: res; {r1}
R2: res; {r2}
R3: res; 50
R4: res; 100
R5: res; 10k
U1: LT1001
U2: LT1001
U4: opamp2; LM324
V1: voltage; 10
V2: voltage; PWL TIME_SCALE_FACTOR=1 VALUE_SCALE_FACTOR=1 REPEAT FOREVER (file=senialDAC_0a3.3V_199puntos_escalon.txt) ENDREPEAT
V3: voltage; SINE(1.6 {vi} 0.5); Rser=0
V4: voltage; 10
V_DAC2: voltage; {voff}; Rser=0
Named nets: +VCC, 0, -VEE, V+, Vo
.tran 0 10 0
V2 = (Vmax(V3)*Av)/(2*(1+Av)) -> siendo Vmax(V3) = 2*Vi
Av = R2/R1
.param vi=1.6 r1=1k r2=3.3k av=r2/r1  voff=vi*av/(1+av)
.include LM324.txt
