potenciostato/potenciostato/ltspice/Salida DAC/prueba_carga_arbitraria.asc

I1: load; EXP(0 0.005 0.01 0.02 0.03 0.01)
R1: res; 1k
V1: voltage; 5
Named nets: 0
.tran 1
