potenciostato/potenciostato/ltspice/potencioV2/potenciostatov2.asc

R1: res; 10k
R2: res; 10k
R3: res; 10k
R4: res; 10k
R6: res; 10k
R7: res; 10k
R8: res; 100k
R9: res; 100k
R10: res; 1k
R11: res; 10k
R12: res; 10k
R13: res; 10k
R14: res; 8k
R15: res; 5k
R16: res; 20k
R17: res; 10k
R18: res; 10k
R19: res; 10k
R20: res; 10k
R21: res; 10k
R22: res; 10k
R23: res; 10k
U1: AD8038
U2: AD8038
U3: AD8038
U4: AD8038
U5: AD8038
U6: AD8038
U7: AD8038
U8: AD8038
U9: AD8038
U10: AD8038
V1: voltage; 5
V2: voltage; 3.3
V4: voltage; 5
V5: voltage; SINE(1.6 1.6 0.5); Rser=0
Named nets: +VCC, 0, -VEE, V, Vref, -Vref, I, +3V3
.tran 0 10 0
V2 = (Vmax(V3)*Av)/(2*(1+Av)) -> siendo Vmax(V3) = 2*Vi
Av = R2/R1
.param vi=1.6 r1=1k r2=3.3k av=r2/r1  voff=vi*av/(1+av)
