potenciostato/potenciostato/ltspice/potencioV2/amp_off.asc

D1: diode
D2: diode
R1: res; 10k
R2: res; 10k
R3: res; 10k
R4: res; 5k
R5: res; 9k
U1: AD8038
V1: voltage; 4
V2: voltage; 4
V3: voltage; SINE(1.6 1.6 0.5); Rser=0
Named nets: 0, +VCC, -VEE, I, Vref
.tran 10
