potenciostato/potenciostato/ltspice/calculos version reducida/potenciostato_xy.asc

C1: cap; 1µ
C2: cap; 1µ
L1: ind; 100µ
R1: res; 10k
R2: res; 10k
R3: res; 5.6k
R4: res; 10k
R5: res; 10k
R6: res; 10k
R7: res; 12.5k
R8: res; 10k
R9: res; 10k
R10: res; 1k
R11: res; 10k
R12: res; 10k
R13: res; 12k
R14: res; 20k
R15: res; 5k
R16: res; 100k
R17: res; 10k
R18: res; 10k
R19: res; 10k
R20: res; 12k
R21: res; 10k
U1: ADA4891-2
U2: ADA4891-2
U3: ADA4891-2
U4: ADA4891-2
U5: ADA4891-2
U6: ADA4891-2
U7: ADA4891-2
U9: ADA4891-2
V1: voltage; 5
V4: voltage; 5
V5: voltage; SINE(1.6 1.6 0.5); Rser=0
Named nets: +VCC, 0, -VEE, V, I
.tran 0 5 0
V2 = (Vmax(V3)*Av)/(2*(1+Av)) -> siendo Vmax(V3) = 2*Vi
Av = R2/R1
.include LM324.txt
