potenciostato/potenciostato/ltspice/calculos version reducida/amplificador_adc_corriente.asc

R1: res; 10k
R5: res; 10k
R6: res; 10k
R7: res; 6060
R8: res; 250
R9: res; 5.6k
R10: res; 500
R11: res; 8.2k
R12: res; 10k
R13: res; 250
R14: res; 750
R16: res
RL1: res; 100k
RL2: res; 100k
U1: LT1001
U2: LT1001
U3: opamp2; LM324
U4: opamp2; LM324
V1: voltage; 5
V2: voltage; PWL TIME_SCALE_FACTOR=0.1 VALUE_SCALE_FACTOR=1 REPEAT FOREVER (file=triangularDAC_0a3.2V_256pts.txt) ENDREPEAT; AC 1.6; Rser=0
V3: voltage; PWL TIME_SCALE_FACTOR=0.1 VALUE_SCALE_FACTOR=1 REPEAT FOREVER (file=triangularDAC_0a3.2V_256pts.txt) ENDREPEAT; AC 1.6; Rser=0
V4: voltage; 5
Named nets: +VCC, 0, -VEE, out
.tran 0.1
.lib LM324.txt
Acá se simula con valores comerciales usando potes de 1k
