potenciostato/potenciostato/ltspice/Salida DAC/amplificador_dac_4016.asc

C1: cap; 220n
C2: cap; 22n
R1: res; 20k
R2: res; 40k
R3: res; 10k
R4: res; 250
R5: res; 500k
R6: res; 500k
R7: res; 10k
R8: res; 250
RL1: res; 100k
U2: LT1001
U4: opamp2; LM324
V1: voltage; 5
V3: voltage; PWL TIME_SCALE_FACTOR=0.1 VALUE_SCALE_FACTOR=1 REPEAT FOREVER (file=triangularDAC_0a3.2V_100pts.txt) ENDREPEAT; AC 1.6; Rser=0
V4: voltage; 5
V_off: voltage; 0.5; Rser=0
Named nets: +VCC, 0, -VEE, out
.tran 1
.lib LM324.txt
;ac dec 200 1 1meg
.four 1kHz V(out)
