potenciostato/potenciostato/ltspice/Salida DAC/amplificador_dac_filtro.asc

C1: cap; 100n
C2: cap; 200n
R1: res; {r1}
R2: res; {r2}
R3: res; {r1}
R5: res; 11.25k
R6: res; 11.25
RL1: res; 1k
RL2: res; 100k
U1: opamp2; LM324
U2: LT1001
U4: opamp2; LM324
V1: voltage; 10
V3: voltage; PWL TIME_SCALE_FACTOR=1 VALUE_SCALE_FACTOR=1 REPEAT FOREVER (file=senialDAC_0a3.3V_escalon_rapido.txt) ENDREPEAT; AC 1.6; Rser=0
V4: voltage; 10
V_DAC2: voltage; {voff}; Rser=0
Named nets: +VCC, 0, -VEE, V+, out
.tran 1
V2 = (Vmax(V3)*Av)/(2*(1+Av)) -> siendo Vmax(V3) = 2*Vi
Av = R2/R1
.param vi=1.6 r1=1k r2=3.3k av=r2/r1  voff=vi*av/(1+av)
.lib LM324.txt
;ac dec 200 1 100k
.four 1kHz V(out)
