potenciostato/potenciostato/ltspice/Salida DAC/amplificador_dac_sin_filtro_sumador.asc

C2: cap; 200n
R1: res; 10k
R2: res; 15k
R3: res; 10k
RL1: res; 1k
U2: LT1001
U4: opamp2; LM324
V1: voltage; 5
V3: voltage; PWL TIME_SCALE_FACTOR=1 VALUE_SCALE_FACTOR=1 REPEAT FOREVER (file=triangularDAC_0a3.2V_256pts.txt) ENDREPEAT; AC 1.6; Rser=0
V4: voltage; 5
V_DAC2: voltage; -1.6; Rser=0
Named nets: +VCC, 0, -VEE, out
.tran 1
.lib LM324.txt
;ac dec 200 1 100k
.four 1kHz V(out)
