potenciostato/potenciostato/(list of files, drawings)

Other design files:
kicadv2/potenciostato.dsn
kicadv2/potenciostato_2.dsn
kicadv2/potenciostato_3.dsn
kicadv2/potenciostato_4.dsn
kicadv2/potenciostato_parcial.dsn
