potenciostato/potenciostato/kicadv2/potenciostato.kicad_pcb

## KiCad design kicadv2/potenciostato.kicad_pcb (2023-02-11)

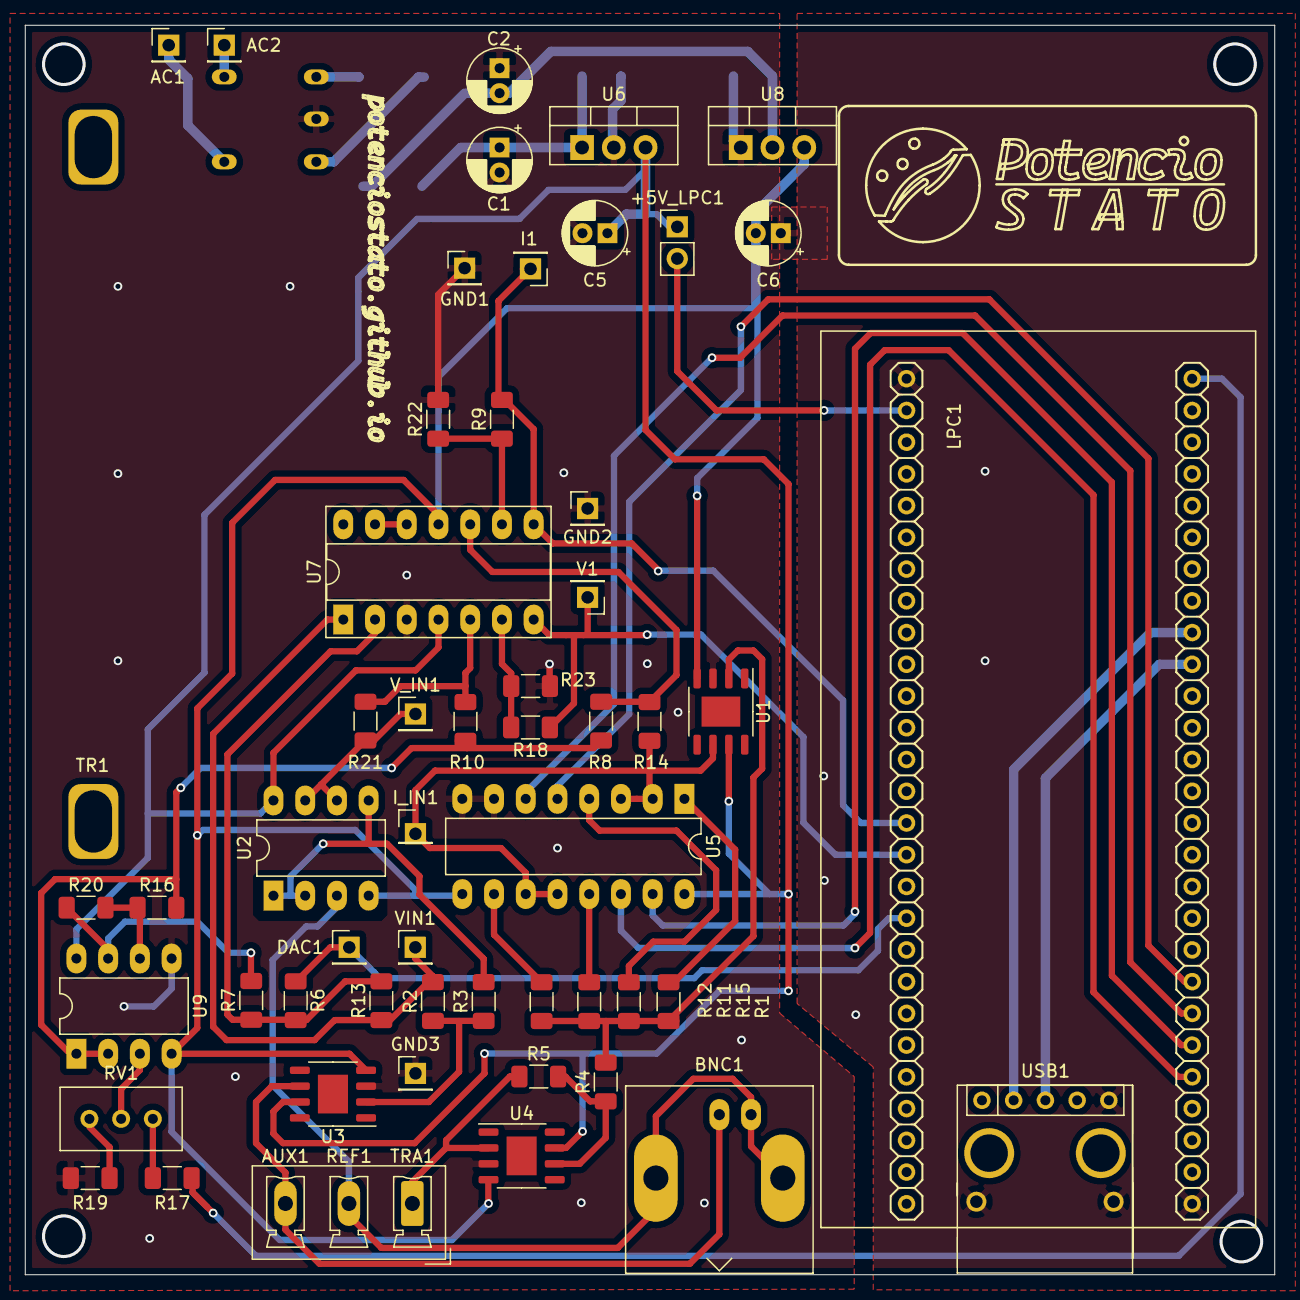
[picture p64: board kicadv2/potenciostato.kicad_pcb from above]

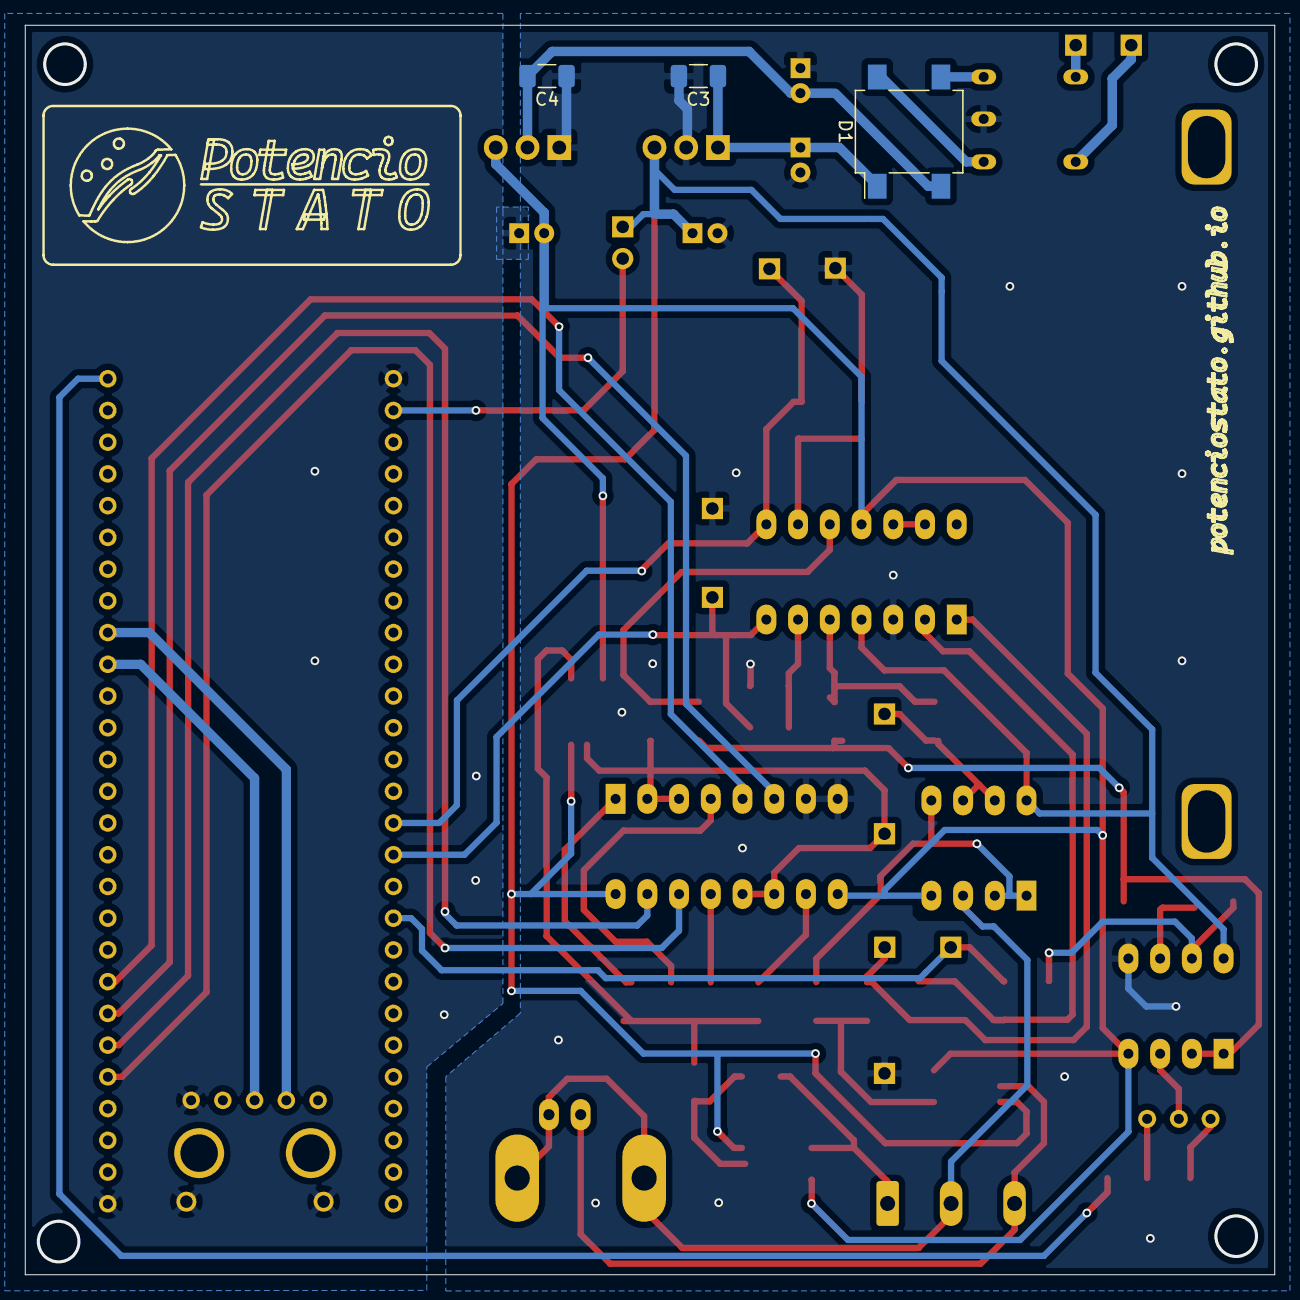
[picture p65: board kicadv2/potenciostato.kicad_pcb from below]

Board: 2 copper layers, 100.0 x 100.0 mm, 57 parts (3 on the bottom side), 46 nets.

Parts:
+5V_LPC1: alimentacion_lpc; PinHeader_1x02_P2.54mm_Vertical
AC1: AC1; PinHeader_1x01_P2.54mm_Vertical
AC2: AC2; PinHeader_1x01_P2.54mm_Vertical
AUX1: Conn_01x03_Male; PhoenixContact_MCV_1,5_3-G-5.08_1x03_P5.08mm_Vertical
BNC1: Conn_Coaxial; BNC_Amphenol_B6252HB-NPP3G-50_Horizontal
C1, C2, C5, C6: 10uF; CP_Radial_D5.0mm_P2.00mm
C3, C4: 100nF; C_1206_3216Metric_Pad1.33x1.80mm_HandSolder
D1: D_Bridge_+-AA; Diode_Bridge_Vishay_DFS
DAC1: test_DAC; PinHeader_1x01_P2.54mm_Vertical
GND1, GND2, GND3: test_GND; PinHeader_1x01_P2.54mm_Vertical
I1: test_I; PinHeader_1x01_P2.54mm_Vertical
I_IN1: test_I; PinHeader_1x01_P2.54mm_Vertical
LPC1: LPCXPRESSO_LPC1769
R1: 1K; R_1206_3216Metric_Pad1.30x1.75mm_HandSolder
R2, R3, R11: 100K; R_1206_3216Metric_Pad1.30x1.75mm_HandSolder
R4, R6, R7, R8, R9, R10, R13, R14, R15, R16, R18, R20, R21, R22, R23: 10K; R_1206_3216Metric_Pad1.30x1.75mm_HandSolder
R5: 6K8; R_1206_3216Metric_Pad1.30x1.75mm_HandSolder
R12, R17: 4K7; R_1206_3216Metric_Pad1.30x1.75mm_HandSolder
R19: 5K6; R_1206_3216Metric_Pad1.30x1.75mm_HandSolder
RV1: 10K; Potentiometer_Bourns_3296W_Vertical
TR1: ADT2-71T; Transformador_7.5V
U1, U3, U4: OP77; HSOP-8-1EP_3.9x4.9mm_P1.27mm_EP2.41x3.1mm
U2, U9: TL082; DIP-8_W7.62mm_LongPads
U5: 4316; DIP-16_W7.62mm_LongPads
U6: L7805; TO-220-3_Vertical
U7: TL064; DIP-14_W7.62mm_Socket_LongPads
U8: L7905; TO-220-3_Vertical
USB1: USB_B_Micro; ModuloUSB-Micro
V1: test_V; PinHeader_1x01_P2.54mm_Vertical
VIN1: test_VIN; PinHeader_1x01_P2.54mm_Vertical
V_IN1: test_V; PinHeader_1x01_P2.54mm_Vertical

Connections:
+5V: +5V_LPC1.1, C5.1, U1.7, U2.8, U3.7, U4.7, U5.16, U6.3, U7.4, U9.8
-5V: C6.2, U1.4, U2.4, U3.4, U4.4, U5.9, U7.11, U8.3, U9.4
/salida_dac/3V3: LPC1.28, R17.2
/salida_dac/-VOffset: R7.2, R20.1, U9.7
/salida_dac/I_IN: I_IN1.1, R14.2, U1.6, U5.2, U5.3, U5.11, U5.12
/salida_dac/VIN: R2.2, R13.1, U7.1, VIN1.1
/salida_dac/VOffset: R8.1, R10.1, R16.2, U9.1, U9.2
/salida_dac/V_IN: R21.2, U2.6, U2.7, V_IN1.1
/salida_dac/gan_x0.1: LPC1.49, U5.15
/salida_dac/gan_x1: LPC1.47, U5.5
/salida_dac/gan_x5: LPC1.48, U5.6
/salida_dac/gan_x10: LPC1.50, U5.14
GND: C1.2, C2.1, C3.2, C4.1, C5.2, C6.1, GND1.1, GND2.1, GND3.1, LPC1.1, LPC1.54, R19.1, R22.2, R23.2, TR1.5, U1.3, U3.3, U4.3, U5.7, U5.8, U6.2, U7.3, U8.1, U9.5, USB1.5, USB1.8, USB1.9
unnamed: +5V_LPC1.2, LPC1.2
unnamed: AC1.1, TR1.3
unnamed: AC2.1, TR1.1
unnamed: AUX1.1, R5.1, U4.2
unnamed: AUX1.2, BNC1.2, U2.3
unnamed: AUX1.3, BNC1.1, U3.6
unnamed: C1.1, C3.1, D1.1, U6.1
unnamed: C2.2, C4.2, D1.2, U8.2
unnamed: D1.3, TR1.6
unnamed: D1.4, TR1.4
unnamed: DAC1.1, LPC1.18, R6.2
unnamed: I1.1, LPC1.15, R9.2, U7.8
unnamed: LPC1.16, R18.1, U7.7, V1.1
unnamed: LPC1.36, USB1.2
unnamed: LPC1.37, USB1.3
unnamed: R1.1, R4.2, R11.1, R12.1, R15.1, U1.2
unnamed: R1.2, U5.1
unnamed: R2.1, R3.1, U3.2
unnamed: R3.2, U2.1, U2.2, U2.5
unnamed: R4.1, R5.2, U4.6
unnamed: R10.2, R21.1, U7.5
unnamed: R11.2, U5.13
unnamed: R12.2, U5.10
unnamed: R6.1, R7.1, R13.2, U7.2
unnamed: R8.2, R14.1, U7.10
unnamed: R15.2, U5.4
unnamed: R16.1, R20.2, U9.6
unnamed: R17.1, RV1.1
unnamed: R18.2, R23.1, U7.6
unnamed: R19.2, RV1.3
unnamed: R9.1, R22.1, U7.9
unnamed: RV1.2, U9.3
unnamed: U7.12, U7.13
