potenciostato/potenciostato/kicad_reducido/potenciostato.kicad_pcb

## KiCad design kicad_reducido/potenciostato.kicad_pcb (2022-10-16)

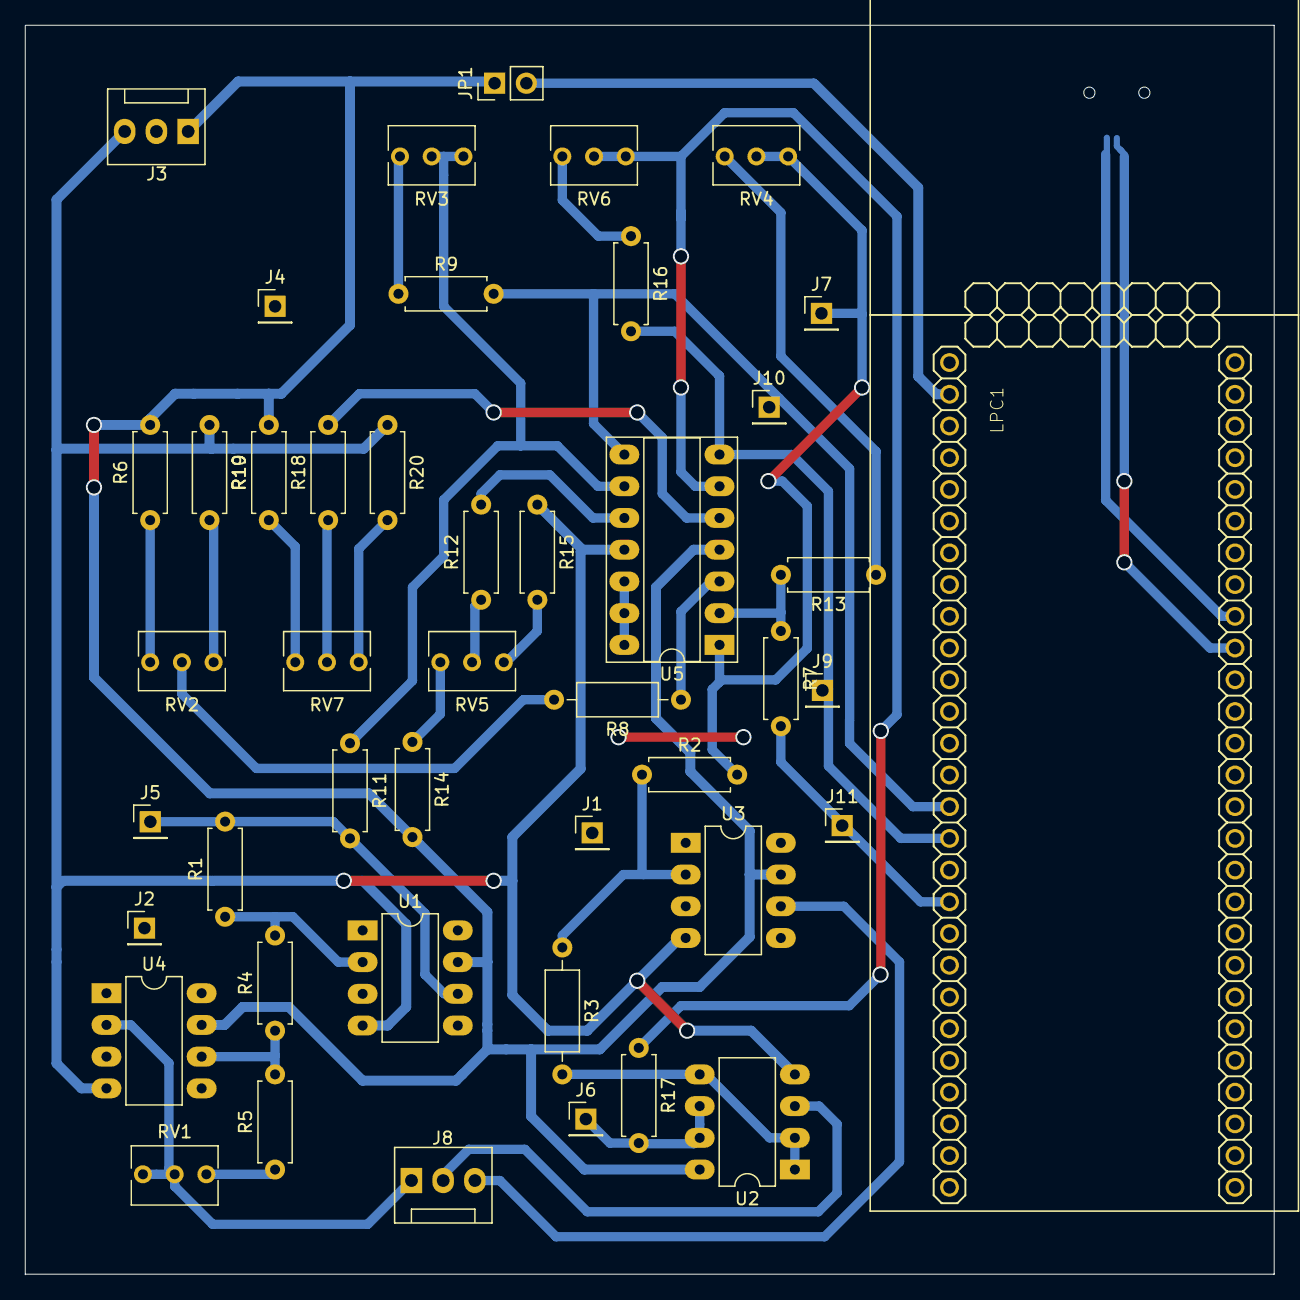
[picture p66: board kicad_reducido/potenciostato.kicad_pcb from above]

Board: 2 copper layers, 100.0 x 100.0 mm, 46 parts (1 on the bottom side), 37 nets.

Parts:
J1, J2, J4, J5, J6, J7, J9, J10, J11: Conn_01x01_Female; PinHeader_1x01_P2.54mm_Vertical
J3: Conn_01x03_Female; FanPinHeader_1x03_P2.54mm_Vertical
J8: Conn_01x03_Male; FanPinHeader_1x03_P2.54mm_Vertical
J12: USB_B_Micro; USB_Mini-B_Wuerth_65100516121_Horizontal
JP1: Jumper; PinHeader_1x02_P2.54mm_Vertical
LPC1: LPCXPRESSO_LPC1769
R1: 33K; R_Axial_DIN0207_L6.3mm_D2.5mm_P7.62mm_Horizontal
R2: 100K; R_Axial_DIN0207_L6.3mm_D2.5mm_P7.62mm_Horizontal
R3: 100K; R_Axial_DIN0207_L6.3mm_D2.5mm_P10.16mm_Horizontal
R4, R7, R10, R11, R12, R14, R17, R18, R19: 10K; R_Axial_DIN0207_L6.3mm_D2.5mm_P7.62mm_Horizontal
R5: 0K; R_Axial_DIN0207_L6.3mm_D2.5mm_P7.62mm_Horizontal
R6: 8.2K; R_Axial_DIN0207_L6.3mm_D2.5mm_P7.62mm_Horizontal
R8: 10K; R_Axial_DIN0207_L6.3mm_D2.5mm_P10.16mm_Horizontal
R9, R16: 4K7; R_Axial_DIN0207_L6.3mm_D2.5mm_P7.62mm_Horizontal
R13: 6K8; R_Axial_DIN0207_L6.3mm_D2.5mm_P7.62mm_Horizontal
R15: 1K; R_Axial_DIN0207_L6.3mm_D2.5mm_P7.62mm_Horizontal
R20: 15K; R_Axial_DIN0207_L6.3mm_D2.5mm_P7.62mm_Horizontal
RV1, RV2, RV4, RV5, RV6, RV7: 1K; Potentiometer_Bourns_3266Y_Vertical
RV3: R_POT; Potentiometer_Bourns_3266Y_Vertical
U1, U3, U4: OP77; DIP-8_W7.62mm_LongPads
U2: TL082; DIP-8_W7.62mm_LongPads
U5: TL064; DIP-14_W7.62mm_Socket_LongPads

Connections:
+5V: J3.1, JP1.1, R6.2, R14.2, R19.2, U1.7, U2.8, U3.7, U4.7, U5.4
-5V: J3.3, R10.1, R15.1, R20.1, U1.4, U2.4, U3.4, U4.4, U5.11
/LPC/ADC0: J10.1, LPC1.15, R9.2, U5.8
/LPC/ADC1: J9.1, LPC1.16, R16.2, U5.7
/LPC/DAC: J11.1, LPC1.18, R7.2
/salida_dac/I_IN: J5.1, R1.2, R11.2, U1.6
/salida_dac/VIN: J7.1, R2.2, RV4.2, RV4.3, U5.1
/salida_dac/V_IN: J6.1, R17.2, U2.6, U2.7
GND: J1.1, J2.1, J3.2, J4.1, J12.5, J12.6, LPC1.1, LPC1.54, U1.3, U3.3, U4.3, U5.12, U5.13, U5.14
unnamed: J8.1, RV1.2, RV1.3, U4.2
unnamed: J8.3, U3.6
unnamed: J12.2, LPC1.36
unnamed: J12.3, LPC1.37
unnamed: JP1.2, LPC1.2
unnamed: R1.1, R4.2, U1.2
unnamed: R2.1, R3.1, U3.2
unnamed: R3.2, U2.1, U2.2, U2.5
unnamed: R4.1, R5.2, U4.6
unnamed: R5.1, RV1.1
unnamed: R6.1, RV2.1
unnamed: R8.1, U5.3
unnamed: R8.2, RV2.2
unnamed: R9.1, RV3.1
unnamed: R10.2, RV2.3
unnamed: R11.1, RV3.2, RV3.3, U5.9
unnamed: R12.1, RV5.2
unnamed: R12.2, U5.10
unnamed: R13.1, RV4.1
unnamed: R7.1, R13.2, U5.2
unnamed: R14.1, RV5.1
unnamed: R15.2, RV5.3
unnamed: R16.1, RV6.1
unnamed: R17.1, RV6.2, RV6.3, U5.6
unnamed: R18.1, RV7.2
unnamed: R18.2, U5.5
unnamed: R19.1, RV7.1
unnamed: R20.2, RV7.3
