potenciostato/potenciostato/workspace/lpc_chip_175x_6x/src/gpdma_17xx_40xx.c

/*
 * @brief LPC17xx/40xx GPDMA driver
 *
 * @note
 * Copyright(C) NXP Semiconductors, 2014
 * All rights reserved.
 *
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
 * @par
 * Permission to use, copy, modify, and distribute this software and its
 * documentation is hereby granted, under NXP Semiconductors' and its
 * licensor's relevant copyrights in the software, without fee, provided that it
 * is used in conjunction with NXP Semiconductors microcontrollers.  This
 * copyright, permission, and disclaimer notice must appear in all copies of
 * this code.
 */

#include "chip.h"

/*****************************************************************************
 * Private types/enumerations/variables
 ****************************************************************************/

/* Channel array to monitor free channel */
static DMA_ChannelHandle_t ChannelHandlerArray[GPDMA_NUMBER_CHANNELS];

#if defined(CHIP_LPC177X_8X) || defined(CHIP_LPC40XX)
/* Optimized Peripheral Source and Destination burst size (177x_8x,407x_8x) */
static const uint8_t GPDMA_LUTPerBurst[] = {
	0,								/* Reserved */
	GPDMA_BSIZE_8,					/* SD Card */
	GPDMA_BSIZE_4,					/* SSP0 Tx */
	GPDMA_BSIZE_4,					/* SSP0 Rx */
	GPDMA_BSIZE_4,					/* SSP1 Tx */
	GPDMA_BSIZE_4,					/* SSP1 Rx */
	GPDMA_BSIZE_4,					/* SSP2 Tx */
	GPDMA_BSIZE_4,					/* SSP2 Rx */
	GPDMA_BSIZE_1,					/* ADC */
	GPDMA_BSIZE_1,					/* DAC */
	GPDMA_BSIZE_1,					/* UART0 Tx */
	GPDMA_BSIZE_1,					/* UART0 Rx */
	GPDMA_BSIZE_1,					/* UART1 Tx */
	GPDMA_BSIZE_1,					/* UART1 Rx */
	GPDMA_BSIZE_1,					/* UART2 Tx */
	GPDMA_BSIZE_1,					/* UART2 Rx */
	GPDMA_BSIZE_1,					/* MAT0.0 */
	GPDMA_BSIZE_1,					/* MAT0.1 */
	GPDMA_BSIZE_1,					/* MAT1.0 */
	GPDMA_BSIZE_1,					/* MAT1.1 */
	GPDMA_BSIZE_1,					/* MAT2.0 */
	GPDMA_BSIZE_1,					/* MAT2.1 */
	GPDMA_BSIZE_32,					/* I2S channel 0 */
	GPDMA_BSIZE_32,					/* I2S channel 1 */
	0,								/* Reserved */
	0,								/* Reserved */
	GPDMA_BSIZE_1,					/* UART3 Tx */
	GPDMA_BSIZE_1,					/* UART3 Rx */
	GPDMA_BSIZE_1,					/* UART4 Tx */
	GPDMA_BSIZE_1,					/* UART4 Rx */
	GPDMA_BSIZE_1,					/* MAT3.0 */
	GPDMA_BSIZE_1,					/* MAT3.1 */
};

/* Optimized Peripheral Source and Destination transfer width (177x_8x,407x_8x) */
static const uint8_t GPDMA_LUTPerWid[] =  {
	0,									/* Reserved */
	GPDMA_WIDTH_WORD,					/* SD Card */
	GPDMA_WIDTH_BYTE,					/* SSP0 Tx */
	GPDMA_WIDTH_BYTE,					/* SSP0 Rx */
	GPDMA_WIDTH_BYTE,					/* SSP1 Tx */
	GPDMA_WIDTH_BYTE,					/* SSP1 Rx */
	GPDMA_WIDTH_BYTE,					/* SSP2 Tx */
	GPDMA_WIDTH_BYTE,					/* SSP2 Rx */
	GPDMA_WIDTH_WORD,					/* ADC */
	GPDMA_WIDTH_HALFWORD,				/* DAC */
	GPDMA_WIDTH_BYTE,					/* UART0 Tx */
	GPDMA_WIDTH_BYTE,					/* UART0 Rx */
	GPDMA_WIDTH_BYTE,					/* UART1 Tx */
	GPDMA_WIDTH_BYTE,					/* UART1 Rx */
	GPDMA_WIDTH_BYTE,					/* UART2 Tx */
	GPDMA_WIDTH_BYTE,					/* UART2 Rx */
	GPDMA_WIDTH_WORD,					/* MAT0.0 */
	GPDMA_WIDTH_WORD,					/* MAT0.1 */
	GPDMA_WIDTH_WORD,					/* MAT1.0 */
	GPDMA_WIDTH_WORD,					/* MAT1.1 */
	GPDMA_WIDTH_WORD,					/* MAT2.0 */
	GPDMA_WIDTH_WORD,					/* MAT2.1 */
	GPDMA_WIDTH_WORD,					/* I2S channel 0 */
	GPDMA_WIDTH_WORD,					/* I2S channel 1 */
	0,									/* Reserved */
	0,									/* Reserved */
	GPDMA_WIDTH_BYTE,					/* UART3 Tx */
	GPDMA_WIDTH_BYTE,					/* UART3 Rx */
	GPDMA_WIDTH_BYTE,					/* UART4 Tx */
	GPDMA_WIDTH_BYTE,					/* UART4 Rx */
	GPDMA_WIDTH_WORD,					/* MAT3.0 */
	GPDMA_WIDTH_WORD,					/* MAT3.1 */
};

/* Lookup Table of Connection Type matched with (177x_8x,407x_8x) Peripheral Data (FIFO) register base address */
volatile static const void *GPDMA_LUTPerAddr[] = {
	0,									/* Reserved */
	(&LPC_SDC->FIFO),					/* SD Card */
	(&LPC_SSP0->DR),					/* SSP0 Tx */
	(&LPC_SSP0->DR),					/* SSP0 Rx */
	(&LPC_SSP1->DR),					/* SSP1 Tx */
	(&LPC_SSP1->DR),					/* SSP1 Rx */
	(&LPC_SSP2->DR),					/* SSP2 Tx */
	(&LPC_SSP2->DR),					/* SSP2 Rx */
	(&LPC_ADC->GDR),					/* ADC */
	(&LPC_DAC->CR),						/* DAC */
	(&LPC_UART0-> /*RBTHDLR.*/ THR),	/* UART0 Tx */
	(&LPC_UART0-> /*RBTHDLR.*/ RBR),	/* UART0 Rx */
	(&LPC_UART1-> /*RBTHDLR.*/ THR),	/* UART1 Tx */
	(&LPC_UART1-> /*RBTHDLR.*/ RBR),	/* UART1 Rx */
	(&LPC_UART2-> /*RBTHDLR.*/ THR),	/* UART2 Tx */
	(&LPC_UART2-> /*RBTHDLR.*/ RBR),	/* UART2 Rx */
	(&LPC_TIMER0->MR[0]),				/* MAT0.0 */
	(&LPC_TIMER0->MR[1]),				/* MAT0.1 */
	(&LPC_TIMER1->MR[0]),				/* MAT1.0 */
	(&LPC_TIMER1->MR[1]),				/* MAT1.1 */
	(&LPC_TIMER2->MR[0]),				/* MAT2.0 */
	(&LPC_TIMER2->MR[1]),				/* MAT2.1 */
	(&LPC_I2S->TXFIFO),					/* I2S Tx */
	(&LPC_I2S->RXFIFO),					/* I2S Rx */
	0,									/* Reverse */
	0,									/* Reverse */
	(&LPC_UART3-> /*RBTHDLR.*/ THR),	/* UART3 Tx */
	(&LPC_UART3-> /*RBTHDLR.*/ RBR),	/* UART3 Rx */
	(&LPC_UART4-> /*RBTHDLR.*/ THR),	/* UART4 Tx */
	(&LPC_UART4-> /*RBTHDLR.*/ RBR),	/* UART4 Rx */
	(&LPC_TIMER3->MR[0]),				/* MAT3.0 */
	(&LPC_TIMER3->MR[1])				/* MAT3.1 */
};

#elif defined(CHIP_LPC175X_6X)
const uint8_t GPDMA_LUTPerBurst[] = {
	GPDMA_BSIZE_4,					// SSP0 Tx
	GPDMA_BSIZE_4,					// SSP0 Rx
	GPDMA_BSIZE_4,					// SSP1 Tx
	GPDMA_BSIZE_4,					// SSP1 Rx
	GPDMA_BSIZE_1,					// ADC
	GPDMA_BSIZE_32,					// I2S channel 0
	GPDMA_BSIZE_32,					// I2S channel 1
	GPDMA_BSIZE_1,					// DAC
	GPDMA_BSIZE_1,					// UART0 Tx
	GPDMA_BSIZE_1,					// UART0 Rx
	GPDMA_BSIZE_1,					// UART1 Tx
	GPDMA_BSIZE_1,					// UART1 Rx
	GPDMA_BSIZE_1,					// UART2 Tx
	GPDMA_BSIZE_1,					// UART2 Rx
	GPDMA_BSIZE_1,					// UART3 Tx
	GPDMA_BSIZE_1,					// UART3 Rx
	GPDMA_BSIZE_1,					// MAT0.0
	GPDMA_BSIZE_1,					// MAT0.1
	GPDMA_BSIZE_1,					// MAT1.0
	GPDMA_BSIZE_1,					// MAT1.1
	GPDMA_BSIZE_1,					// MAT2.0
	GPDMA_BSIZE_1,					// MAT2.1
	GPDMA_BSIZE_1,					// MAT3.0
	GPDMA_BSIZE_1					// MAT3.1
};

/**
 * @brief Optimized Peripheral Source and Destination transfer width
 */
const uint8_t GPDMA_LUTPerWid[] = {
	GPDMA_WIDTH_BYTE,					// SSP0 Tx
	GPDMA_WIDTH_BYTE,					// SSP0 Rx
	GPDMA_WIDTH_BYTE,					// SSP1 Tx
	GPDMA_WIDTH_BYTE,					// SSP1 Rx
	GPDMA_WIDTH_WORD,					// ADC
	GPDMA_WIDTH_WORD,					// I2S channel 0
	GPDMA_WIDTH_WORD,					// I2S channel 1
	GPDMA_WIDTH_HALFWORD,				// DAC
	GPDMA_WIDTH_BYTE,					// UART0 Tx
	GPDMA_WIDTH_BYTE,					// UART0 Rx
	GPDMA_WIDTH_BYTE,					// UART1 Tx
	GPDMA_WIDTH_BYTE,					// UART1 Rx
	GPDMA_WIDTH_BYTE,					// UART2 Tx
	GPDMA_WIDTH_BYTE,					// UART2 Rx
	GPDMA_WIDTH_BYTE,					// UART3 Tx
	GPDMA_WIDTH_BYTE,					// UART3 Rx
	GPDMA_WIDTH_WORD,					// MAT0.0
	GPDMA_WIDTH_WORD,					// MAT0.1
	GPDMA_WIDTH_WORD,					// MAT1.0
	GPDMA_WIDTH_WORD,					// MAT1.1
	GPDMA_WIDTH_WORD,					// MAT2.0
	GPDMA_WIDTH_WORD,					// MAT2.1
	GPDMA_WIDTH_WORD,					// MAT3.0
	GPDMA_WIDTH_WORD					// MAT3.1
};

/**
 * @brief Peripheral Source and Destination address
 */
volatile const void *GPDMA_LUTPerAddr[] = {
	(&LPC_SSP0->DR),					// SSP0 Tx
	(&LPC_SSP0->DR),					// SSP0 Rx
	(&LPC_SSP1->DR),					// SSP1 Tx
	(&LPC_SSP1->DR),					// SSP1 Rx
	(&LPC_ADC->GDR),				// ADC
	(&LPC_I2S->TXFIFO),				// I2S Tx
	(&LPC_I2S->RXFIFO),				// I2S Rx
	(&LPC_DAC->CR),					// DAC
	(&LPC_UART0-> /*RBTHDLR.*/ THR),	// UART0 Tx
	(&LPC_UART0-> /*RBTHDLR.*/ RBR),	// UART0 Rx
	(&LPC_UART1-> /*RBTHDLR.*/ THR),	// UART1 Tx
	(&LPC_UART1-> /*RBTHDLR.*/ RBR),	// UART1 Rx
	(&LPC_UART2-> /*RBTHDLR.*/ THR),	// UART2 Tx
	(&LPC_UART2-> /*RBTHDLR.*/ RBR),	// UART2 Rx
	(&LPC_UART3-> /*RBTHDLR.*/ THR),	// UART3 Tx
	(&LPC_UART3-> /*RBTHDLR.*/ RBR),	// UART3 Rx
	(&LPC_TIMER0->MR[0]),					// MAT0.0
	(&LPC_TIMER0->MR[1]),					// MAT0.1
	(&LPC_TIMER1->MR[0]),					// MAT1.0
	(&LPC_TIMER1->MR[1]),					// MAT1.1
	(&LPC_TIMER2->MR[0]),					// MAT2.0
	(&LPC_TIMER2->MR[1]),					// MAT2.1
	(&LPC_TIMER3->MR[0]),					// MAT3.0
	(&LPC_TIMER3->MR[1])					// MAT3.1

};
#endif

/*****************************************************************************
 * Public types/enumerations/variables
 ****************************************************************************/

/*****************************************************************************
 * Private functions
 ****************************************************************************/

/* Control which set of peripherals is connected to the DMA controller */
STATIC uint8_t configDMAMux(uint32_t gpdma_peripheral_connection_number)
{
#if defined(CHIP_LPC175X_6X)
	if (gpdma_peripheral_connection_number > 15) {
		LPC_SYSCTL->DMAREQSEL |= (1 << (gpdma_peripheral_connection_number - 16));
		return gpdma_peripheral_connection_number - 8;
	}
	else {
		if (gpdma_peripheral_connection_number > 7) {
			LPC_SYSCTL->DMAREQSEL &= ~(1 << (gpdma_peripheral_connection_number - 8));
		}
		return gpdma_peripheral_connection_number;
	}
#elif defined(CHIP_LPC177X_8X) || defined(CHIP_LPC40XX)
	if (gpdma_peripheral_connection_number > 15) {
		LPC_SYSCTL->DMAREQSEL |= (1 << (gpdma_peripheral_connection_number - 16));
		return gpdma_peripheral_connection_number - 16;
	}
	else {
		LPC_SYSCTL->DMAREQSEL &= ~(1 << (gpdma_peripheral_connection_number));
		return gpdma_peripheral_connection_number;
	}
#endif
}

uint32_t makeCtrlWord(const GPDMA_CH_CFG_T *GPDMAChannelConfig,
					  uint32_t GPDMA_LUTPerBurstSrcConn,
					  uint32_t GPDMA_LUTPerBurstDstConn,
					  uint32_t GPDMA_LUTPerWidSrcConn,
					  uint32_t GPDMA_LUTPerWidDstConn)
{
	uint32_t ctrl_word = 0;

	switch (GPDMAChannelConfig->TransferType) {
	/* Memory to memory */
	case GPDMA_TRANSFERTYPE_M2M_CONTROLLER_DMA:
		ctrl_word = GPDMA_DMACCxControl_TransferSize(GPDMAChannelConfig->TransferSize)
					| GPDMA_DMACCxControl_SBSize((4UL))				/**< Burst size = 32 */
					| GPDMA_DMACCxControl_DBSize((4UL))				/**< Burst size = 32 */
					| GPDMA_DMACCxControl_SWidth(GPDMAChannelConfig->TransferWidth)
					| GPDMA_DMACCxControl_DWidth(GPDMAChannelConfig->TransferWidth)
					| GPDMA_DMACCxControl_SI
					| GPDMA_DMACCxControl_DI
					| GPDMA_DMACCxControl_I;
		break;

	case GPDMA_TRANSFERTYPE_M2P_CONTROLLER_DMA:
	case GPDMA_TRANSFERTYPE_M2P_CONTROLLER_PERIPHERAL:
		ctrl_word = GPDMA_DMACCxControl_TransferSize((uint32_t) GPDMAChannelConfig->TransferSize)
					| GPDMA_DMACCxControl_SBSize(GPDMA_LUTPerBurstDstConn)
					| GPDMA_DMACCxControl_DBSize(GPDMA_LUTPerBurstDstConn)
					| GPDMA_DMACCxControl_SWidth(GPDMA_LUTPerWidDstConn)
					| GPDMA_DMACCxControl_DWidth(GPDMA_LUTPerWidDstConn)
					| GPDMA_DMACCxControl_DestTransUseAHBMaster1
					| GPDMA_DMACCxControl_SI
					| GPDMA_DMACCxControl_I;
		break;

	case GPDMA_TRANSFERTYPE_P2M_CONTROLLER_DMA:
	case GPDMA_TRANSFERTYPE_P2M_CONTROLLER_PERIPHERAL:
		ctrl_word = GPDMA_DMACCxControl_TransferSize((uint32_t) GPDMAChannelConfig->TransferSize)
					| GPDMA_DMACCxControl_SBSize(GPDMA_LUTPerBurstSrcConn)
					| GPDMA_DMACCxControl_DBSize(GPDMA_LUTPerBurstSrcConn)
					| GPDMA_DMACCxControl_SWidth(GPDMA_LUTPerWidSrcConn)
					| GPDMA_DMACCxControl_DWidth(GPDMA_LUTPerWidSrcConn)
					| GPDMA_DMACCxControl_SrcTransUseAHBMaster1
					| GPDMA_DMACCxControl_DI
					| GPDMA_DMACCxControl_I;
		break;

	case GPDMA_TRANSFERTYPE_P2P_CONTROLLER_DMA:
	case GPDMA_TRANSFERTYPE_P2P_CONTROLLER_DestPERIPHERAL:
	case GPDMA_TRANSFERTYPE_P2P_CONTROLLER_SrcPERIPHERAL:
		ctrl_word = GPDMA_DMACCxControl_TransferSize((uint32_t) GPDMAChannelConfig->TransferSize)
					| GPDMA_DMACCxControl_SBSize(GPDMA_LUTPerBurstSrcConn)
					| GPDMA_DMACCxControl_DBSize(GPDMA_LUTPerBurstDstConn)
					| GPDMA_DMACCxControl_SWidth(GPDMA_LUTPerWidSrcConn)
					| GPDMA_DMACCxControl_DWidth(GPDMA_LUTPerWidDstConn)
					| GPDMA_DMACCxControl_SrcTransUseAHBMaster1
					| GPDMA_DMACCxControl_DestTransUseAHBMaster1
					| GPDMA_DMACCxControl_I;

		break;

	/* Do not support any more transfer type, return ERROR */
	default:
		return ERROR;
	}
	return ctrl_word;
}

/* Set up the DPDMA according to the specification configuration details */
Status setupChannel(LPC_GPDMA_T *pGPDMA,
					GPDMA_CH_CFG_T *GPDMAChannelConfig,
					uint32_t CtrlWord,
					uint32_t LinkListItem,
					uint8_t SrcPeripheral,
					uint8_t DstPeripheral)
{
	GPDMA_CH_T *pDMAch;

	if (pGPDMA->ENBLDCHNS & ((((1UL << (GPDMAChannelConfig->ChannelNum)) & 0xFF)))) {
		/* This channel is enabled, return ERROR, need to release this channel first */
		return ERROR;
	}

	/* Get Channel pointer */
	pDMAch = (GPDMA_CH_T *) &(pGPDMA->CH[GPDMAChannelConfig->ChannelNum]);

	/* Reset the Interrupt status */
	pGPDMA->INTTCCLEAR = (((1UL << (GPDMAChannelConfig->ChannelNum)) & 0xFF));
	pGPDMA->INTERRCLR = (((1UL << (GPDMAChannelConfig->ChannelNum)) & 0xFF));

	/* Assign Linker List Item value */
	pDMAch->LLI = LinkListItem;

	/* Enable DMA channels, little endian */
	pGPDMA->CONFIG = GPDMA_DMACConfig_E;
	while (!(pGPDMA->CONFIG & GPDMA_DMACConfig_E)) {}

	pDMAch->SRCADDR = GPDMAChannelConfig->SrcAddr;
	pDMAch->DESTADDR = GPDMAChannelConfig->DstAddr;

	/* Configure DMA Channel, enable Error Counter and Terminate counter */
	pDMAch->CONFIG = GPDMA_DMACCxConfig_IE
					 | GPDMA_DMACCxConfig_ITC		/*| GPDMA_DMACCxConfig_E*/
					 | GPDMA_DMACCxConfig_TransferType((uint32_t) GPDMAChannelConfig->TransferType)
					 | GPDMA_DMACCxConfig_SrcPeripheral(SrcPeripheral)
					 | GPDMA_DMACCxConfig_DestPeripheral(DstPeripheral);

	pDMAch->CONTROL = CtrlWord;

	return SUCCESS;
}

/*****************************************************************************
 * Public functions
 ****************************************************************************/

/* Initialize the GPDMA */
void Chip_GPDMA_Init(LPC_GPDMA_T *pGPDMA)
{
	uint8_t i;

	Chip_Clock_EnablePeriphClock(SYSCTL_CLOCK_GPDMA);

	/* Reset all channel configuration register */
	for (i = 8; i > 0; i--) {
		pGPDMA->CH[i - 1].CONFIG = 0;
	}

	/* Clear all DMA interrupt and error flag */
	pGPDMA->INTTCCLEAR = 0xFF;
	pGPDMA->INTERRCLR = 0xFF;

	/* Reset all channels are free */
	for (i = 0; i < GPDMA_NUMBER_CHANNELS; i++) {
		ChannelHandlerArray[i].ChannelStatus = DISABLE;
	}
}

/* Shutdown the GPDMA */
void Chip_GPDMA_DeInit(LPC_GPDMA_T *pGPDMA)
{
	Chip_Clock_DisablePeriphClock(SYSCTL_CLOCK_GPDMA);
}

/* Stop a stream DMA transfer */
void Chip_GPDMA_Stop(LPC_GPDMA_T *pGPDMA,
					 uint8_t ChannelNum)
{
	Chip_GPDMA_ChannelCmd(pGPDMA, (ChannelNum), DISABLE);
	if (Chip_GPDMA_IntGetStatus(pGPDMA, GPDMA_STAT_INTTC, ChannelNum)) {
		/* Clear terminate counter Interrupt pending */
		Chip_GPDMA_ClearIntPending(pGPDMA, GPDMA_STATCLR_INTTC, ChannelNum);
	}
	if (Chip_GPDMA_IntGetStatus(pGPDMA, GPDMA_STAT_INTERR, ChannelNum)) {
		/* Clear terminate counter Interrupt pending */
		Chip_GPDMA_ClearIntPending(pGPDMA, GPDMA_STATCLR_INTERR, ChannelNum);
	}
	ChannelHandlerArray[ChannelNum].ChannelStatus = DISABLE;
}

/* The GPDMA stream interrupt status checking */
Status Chip_GPDMA_Interrupt(LPC_GPDMA_T *pGPDMA,
							uint8_t ChannelNum)
{

	if (Chip_GPDMA_IntGetStatus(pGPDMA, GPDMA_STAT_INT, ChannelNum)) {
		/* Check counter terminal status */
		if (Chip_GPDMA_IntGetStatus(pGPDMA, GPDMA_STAT_INTTC, ChannelNum)) {
			/* Clear terminate counter Interrupt pending */
			Chip_GPDMA_ClearIntPending(pGPDMA, GPDMA_STATCLR_INTTC, ChannelNum);
			return SUCCESS;
		}
		/* Check error terminal status */
		if (Chip_GPDMA_IntGetStatus(pGPDMA, GPDMA_STAT_INTERR, ChannelNum)) {
			/* Clear error counter Interrupt pending */

			Chip_GPDMA_ClearIntPending(pGPDMA, GPDMA_STATCLR_INTERR, ChannelNum);
			return ERROR;
		}
	}
	return ERROR;
}

int Chip_GPDMA_InitChannelCfg(LPC_GPDMA_T *pGPDMA,
							  GPDMA_CH_CFG_T *GPDMACfg,
							  uint8_t  ChannelNum,
							  uint32_t src,
							  uint32_t dst,
							  uint32_t Size,
							  GPDMA_FLOW_CONTROL_T TransferType)
{
	int rval = -1;
	GPDMACfg->ChannelNum = ChannelNum;
	GPDMACfg->TransferType = TransferType;
	GPDMACfg->TransferSize = Size;

	switch (TransferType) {
	case GPDMA_TRANSFERTYPE_M2M_CONTROLLER_DMA:
		GPDMACfg->SrcAddr = (uint32_t) src;
		GPDMACfg->DstAddr = (uint32_t) dst;
		rval = 3;
		GPDMACfg->TransferWidth = GPDMA_WIDTH_WORD;
		GPDMACfg->TransferSize = Size / 4;
		break;

	case GPDMA_TRANSFERTYPE_M2P_CONTROLLER_DMA:
	case GPDMA_TRANSFERTYPE_M2P_CONTROLLER_PERIPHERAL:
		GPDMACfg->SrcAddr = (uint32_t) src;
		rval = 1;
		GPDMACfg->DstAddr = (uint32_t) GPDMA_LUTPerAddr[dst];
		break;

	case GPDMA_TRANSFERTYPE_P2M_CONTROLLER_DMA:
	case GPDMA_TRANSFERTYPE_P2M_CONTROLLER_PERIPHERAL:
		GPDMACfg->SrcAddr = (uint32_t) GPDMA_LUTPerAddr[src];
		GPDMACfg->DstAddr = (uint32_t) dst;
		rval = 2;
		break;

	case GPDMA_TRANSFERTYPE_P2P_CONTROLLER_DMA:
	case GPDMA_TRANSFERTYPE_P2P_CONTROLLER_DestPERIPHERAL:
	case GPDMA_TRANSFERTYPE_P2P_CONTROLLER_SrcPERIPHERAL:
		GPDMACfg->SrcAddr = (uint32_t) GPDMA_LUTPerAddr[src];
		GPDMACfg->DstAddr = (uint32_t) GPDMA_LUTPerAddr[dst];
		rval = 0;
		break;

	default:
		break;
	}
	return rval;
}

/* Read the status from different registers according to the type */
IntStatus Chip_GPDMA_IntGetStatus(LPC_GPDMA_T *pGPDMA, GPDMA_STATUS_T type, uint8_t channel)
{
	/**
	 * TODO check the channel <=8 type is exited
	 */
	switch (type) {
	case GPDMA_STAT_INT:/* check status of DMA channel interrupts */
		return (IntStatus) (pGPDMA->INTSTAT & (((1UL << channel) & 0xFF)));

	case GPDMA_STAT_INTTC:	/* check terminal count interrupt request status for DMA */
		return (IntStatus) (pGPDMA->INTTCSTAT & (((1UL << channel) & 0xFF)));

	case GPDMA_STAT_INTERR:	/* check interrupt status for DMA channels */
		return (IntStatus) (pGPDMA->INTERRSTAT & (((1UL << channel) & 0xFF)));

	case GPDMA_STAT_RAWINTTC:	/* check status of the terminal count interrupt for DMA channels */
		return (IntStatus) (pGPDMA->RAWINTTCSTAT & (((1UL << channel) & 0xFF)));

	case GPDMA_STAT_RAWINTERR:	/* check status of the error interrupt for DMA channels */
		return (IntStatus) (pGPDMA->RAWINTERRSTAT & (((1UL << channel) & 0xFF)));

	default:/* check enable status for DMA channels */
		return (IntStatus) (pGPDMA->ENBLDCHNS & (((1UL << channel) & 0xFF)));
	}
}

/* Clear the Interrupt Flag from different registers according to the type */
void Chip_GPDMA_ClearIntPending(LPC_GPDMA_T *pGPDMA, GPDMA_STATECLEAR_T type, uint8_t channel)
{
	if (type == GPDMA_STATCLR_INTTC) {
		/* clears the terminal count interrupt request on DMA channel */
		pGPDMA->INTTCCLEAR = (((1UL << (channel)) & 0xFF));
	}
	else {
		/* clear the error interrupt request */
		pGPDMA->INTERRCLR = (((1UL << (channel)) & 0xFF));
	}
}

/* Enable or Disable the GPDMA Channel */
void Chip_GPDMA_ChannelCmd(LPC_GPDMA_T *pGPDMA, uint8_t channelNum, FunctionalState NewState)
{
	GPDMA_CH_T *pDMAch;

	/* Get Channel pointer */
	pDMAch = (GPDMA_CH_T *) &(pGPDMA->CH[channelNum]);

	if (NewState == ENABLE) {
		pDMAch->CONFIG |= GPDMA_DMACCxConfig_E;
	}
	else {
		pDMAch->CONFIG &= ~GPDMA_DMACCxConfig_E;
	}
}

/* Do a DMA transfer M2M, M2P,P2M or P2P */
Status Chip_GPDMA_Transfer(LPC_GPDMA_T *pGPDMA,
						   uint8_t ChannelNum,
						   uint32_t src,
						   uint32_t dst,
						   GPDMA_FLOW_CONTROL_T TransferType,
						   uint32_t Size)
{
	GPDMA_CH_CFG_T GPDMACfg;
	uint8_t SrcPeripheral = 0, DstPeripheral = 0;
	uint32_t cwrd;
	int ret;

	ret = Chip_GPDMA_InitChannelCfg(pGPDMA, &GPDMACfg, ChannelNum, src, dst, Size, TransferType);
	if (ret < 0) {
		return ERROR;
	}

	/* Adjust src/dst index if they are memory */
	if (ret & 1) {
		src = 0;
	}
	else {
		SrcPeripheral = configDMAMux(src);
	}

	if (ret & 2) {
		dst = 0;
	}
	else {
		DstPeripheral = configDMAMux(dst);
	}

	cwrd = makeCtrlWord(&GPDMACfg,
						(uint32_t) GPDMA_LUTPerBurst[src],
						(uint32_t) GPDMA_LUTPerBurst[dst],
						(uint32_t) GPDMA_LUTPerWid[src],
						(uint32_t) GPDMA_LUTPerWid[dst]);
	if (setupChannel(pGPDMA, &GPDMACfg, cwrd, 0, SrcPeripheral, DstPeripheral) == ERROR) {
		return ERROR;
	}

	/* Start the Channel */
	Chip_GPDMA_ChannelCmd(pGPDMA, ChannelNum, ENABLE);
	return SUCCESS;
}

Status Chip_GPDMA_PrepareDescriptor(LPC_GPDMA_T *pGPDMA,
									DMA_TransferDescriptor_t *DMADescriptor,
									uint32_t src,
									uint32_t dst,
									uint32_t Size,
									GPDMA_FLOW_CONTROL_T TransferType,
									const DMA_TransferDescriptor_t *NextDescriptor)
{
	int ret;
	GPDMA_CH_CFG_T GPDMACfg;

	ret = Chip_GPDMA_InitChannelCfg(pGPDMA, &GPDMACfg, 0, src, dst, Size, TransferType);
	if (ret < 0) {
		return ERROR;
	}

	/* Adjust src/dst index if they are memory */
	if (ret & 1) {
		src = 0;
	}

	if (ret & 2) {
		dst = 0;
	}

	DMADescriptor->src  = GPDMACfg.SrcAddr;
	DMADescriptor->dst  = GPDMACfg.DstAddr;
	DMADescriptor->lli  = (uint32_t) NextDescriptor;
	DMADescriptor->ctrl = makeCtrlWord(&GPDMACfg,
									   (uint32_t) GPDMA_LUTPerBurst[src],
									   (uint32_t) GPDMA_LUTPerBurst[dst],
									   (uint32_t) GPDMA_LUTPerWid[src],
									   (uint32_t) GPDMA_LUTPerWid[dst]);

	/* By default set interrupt only for last transfer */
	if (NextDescriptor) {
		DMADescriptor->ctrl &= ~GPDMA_DMACCxControl_I;
	}

	return SUCCESS;
}

/* Do a DMA scatter-gather transfer M2M, M2P,P2M or P2P using DMA descriptors */
Status Chip_GPDMA_SGTransfer(LPC_GPDMA_T *pGPDMA,
							 uint8_t ChannelNum,
							 const DMA_TransferDescriptor_t *DMADescriptor,
							 GPDMA_FLOW_CONTROL_T TransferType)
{
	const DMA_TransferDescriptor_t *dsc = DMADescriptor;
	GPDMA_CH_CFG_T GPDMACfg;
	uint8_t SrcPeripheral = 0, DstPeripheral = 0;
	uint32_t src = DMADescriptor->src, dst = DMADescriptor->dst;

	dst = (uint32_t) GPDMA_CONN_DAC; // Se debe forzar ésta condición. Caso contrario no funcionaría porque
									 // la función Chip_GPDMA_InitChannegCfg acepta un índice de periferico
									 // y no la posición absoluta. IDEM línea 684 aquí debajo.
	int ret;

	ret = Chip_GPDMA_InitChannelCfg(pGPDMA, &GPDMACfg, ChannelNum, src, dst, 0, TransferType);
	if (ret < 0) {
		return ERROR;
	}

	/* Adjust src/dst index if they are memory */
	if (ret & 1) {
		src = 0;
	}
	else {
		SrcPeripheral = configDMAMux(src);
	}

	if (ret & 2) {
		dst = 0;
	}
	else {
		DstPeripheral = configDMAMux(dst);
	}

	if (setupChannel(pGPDMA, &GPDMACfg, dsc->ctrl, dsc->lli, SrcPeripheral, DstPeripheral) == ERROR) {
		return ERROR;
	}

	/* Start the Channel */
	Chip_GPDMA_ChannelCmd(pGPDMA, ChannelNum, ENABLE);
	return SUCCESS;
}

/* Do a DMA scatter-gather transfer M2M, M2P,P2M or P2P using DMA descriptors */
Status Chip_GPDMA_SGTransfer_ADC(LPC_GPDMA_T *pGPDMA,
							 uint8_t ChannelNum,
							 const DMA_TransferDescriptor_t *DMADescriptor,
							 GPDMA_FLOW_CONTROL_T TransferType)
{
	const DMA_TransferDescriptor_t *dsc = DMADescriptor;
	GPDMA_CH_CFG_T GPDMACfg;
	uint8_t SrcPeripheral = 0, DstPeripheral = 0;
	uint32_t src = DMADescriptor->src, dst = DMADescriptor->dst;

	src = (uint32_t) GPDMA_CONN_ADC; // Se debe forzar ésta condición. Caso contrario no funcionaría porque
									 // la función Chip_GPDMA_InitChannegCfg acepta un índice de periferico
									 // y no la posición absoluta. IDEM línea 684 aquí debajo.
	int ret;

	ret = Chip_GPDMA_InitChannelCfg(pGPDMA, &GPDMACfg, ChannelNum, src, dst, 0, TransferType);
	if (ret < 0) {
		return ERROR;
	}

	/* Adjust src/dst index if they are memory */
	if (ret & 1) {
		src = 0;
	}
	else {
		SrcPeripheral = configDMAMux(src);
	}

	if (ret & 2) {
		dst = 0;
	}
	else {
		DstPeripheral = configDMAMux(dst);
	}

	if (setupChannel(pGPDMA, &GPDMACfg, dsc->ctrl, dsc->lli, SrcPeripheral, DstPeripheral) == ERROR) {
		return ERROR;
	}

	/* Start the Channel */
	Chip_GPDMA_ChannelCmd(pGPDMA, ChannelNum, ENABLE);
	return SUCCESS;
}

/* Get a free GPDMA channel for one DMA connection */
uint8_t Chip_GPDMA_GetFreeChannel(LPC_GPDMA_T *pGPDMA,
								  uint32_t PeripheralConnection_ID)
{
	uint8_t temp = 0;
	for (temp = 0; temp < GPDMA_NUMBER_CHANNELS; temp++) {
		if (!Chip_GPDMA_IntGetStatus(pGPDMA, GPDMA_STAT_ENABLED_CH,
									 temp) && (ChannelHandlerArray[temp].ChannelStatus == DISABLE)) {
			ChannelHandlerArray[temp].ChannelStatus = ENABLE;
			return temp;
		}
	}
	return 0;
}
