potenciostato/potenciostato/(commit log)

2021-03-25 agrego workspace LPC y kicad
    [LPC.sch, potenciostato.kicad_pcb, potenciostato.sch, salida_dac.sch]
2021-03-26 cola adc funcionando, ver \0
2021-03-26 agrego setup.c y clean de proyectos
2021-03-26 hago clean de proyectos y agrego al gitignore .axf .o .d .mk
2021-03-30 continuacion ruteo pcb
    [potenciostato.kicad_pcb]
2021-04-06 modifique la int del qt,la tarea de la uart y la del adc para que usen colas
2021-04-08 agrego colas al handler de USB
2021-04-13 arreglado bug usb, cambios en board.c
    [board.c]
2021-04-13 commiteo para poder pullear
2021-04-15 agrego programas para simular QT
2021-04-20 Copie el codigo de blinky en potenciostato
2021-04-25 agregar identificador y comentarios a amplificadores
    [LPC.sch, potenciostato.sch, salida_dac.sch]
2021-05-11 agregada huella del lpc al pcb
    [LPC.sch, potenciostato.kicad_pcb, potenciostato.sch, salida_dac.sch]
2021-05-11 Prueba Gus
    [potenciostato.kicad_pcb]
2021-05-16 ruteado LPC, falta pines
    [LPC.sch, potenciostato.kicad_pcb, potenciostato_autoroute.kicad_pcb]
2021-06-27 tarea adc con dma funcionando
2021-07-11 antes de cambiar de estrategia tarea adc
2021-07-11 Tarea ADC implementada por interrupciones
2021-07-17 ajustes handler ADC
2021-07-27 nuevo CO_SENDDATA_ERR cuando no hay datos, cambio qUSBin por qUSBout, error tarea ADC
    [defines.h, hid_generic.c, main.c]
2021-07-31 eliminado pro.user para el gitignoe
2021-07-31 eliminado binarios del Sinte, solo quedo el codigo fuente
2021-08-01 se envia corriente y tension al ADCcrudo
2021-08-15 Se soluciono para poder medir varias veces, hasta el momento solo se podia medir una sola vez, la proxima no arrancaba
2021-08-15 primera version con graficos de puntos en QT
2021-08-24 Modificaciones en schematic
    [LPC.sch, doxygen.cfg, potenciostato.sch, salida_dac.sch]
2021-08-28 dac funcionando de 0 a 3.3v con corrimiento << 6
2021-08-28 onda de 120 muestras a 1000 muestras
2021-08-28 modifique las llaves para reflejar que sw_gain 1 y sw_gain2 estaban al reves
2021-09-02 Generé funcion para activar ganancias y switches
2021-09-04 Actualicé los valores en PCB
    [potenciostato.kicad_pcb]
2021-09-04 modificamos R22 que estaba mal anotada
    [salida_dac.sch]
2021-09-05 modificaciones finales al kickad
    [potenciostato.kicad_pcb, salida_dac.sch]
2021-09-11 Tipo de medicion en Qt Barrido Lineal preparado, falta Ciclico
2021-09-18 resolver envio de refresco al grafico cuando termina la conexion
    [mainwindow.cpp]
2021-10-02 valor de tension desde qt, valor medio de dac
2021-10-02 correciones valor medio dac
    [potenciostato-B_Cu.gbr, potenciostato-job.gbrjob]
2021-10-09 P2.6 a P2.7 en kicad, resuelto escalado de la señal en LPC
    [LPC.sch, potenciostato.sch]
2021-10-16 creado kicad reducido version 2
    [LPC.sch, potenciostato.csv, potenciostato.dsn, potenciostato.kicad_pcb, potenciostato.sch, potenciostato_branch.kicad_pcb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]
2021-10-16 ruteado kicad reducido parcialmente completo
    [LPC.sch, potenciostato.kicad_pcb, potenciostato.sch, potenciostato_2.dsn, potenciostato_3.dsn, potenciostato_4.dsn, potenciostato_parcial.dsn, salida_dac.sch]
2021-10-16 ruteando kicad reducido parte 2
    [potenciostato.kicad_pcb]
2021-10-21 pcb reducido en 10x10
    [LPC.sch, potenciostato.kicad_pcb, potenciostato.sch]
2021-10-22 pcb reducido listo falta revisar
    [LPC.sch, potenciostato.kicad_pcb, potenciostato.sch, salida_dac.sch]
2021-11-27 cambio huella usb
    [potenciostato.kicad_pcb]
2021-11-28 calculos resistencias dac
    [salida_dac.sch]
2021-12-06 modificaciones R
    [potenciostato.sch, salida_dac.sch]
2022-01-08 se configura PINSEL para CH1 ADC0
2022-01-15 se quitan lineas de prueba tarea ADC
2022-01-19 pclk/8 y n ciclos para dac
2022-01-24 se bajo la frec minima a 0,2Hz y la máxima a 8000Hz
2022-01-29 resuelto el abort al finalizar la cantidad de ciclos desde qt y LPC
2022-01-29 corregido el inicio de medicion y termino con abort desacoplado del termino de la medicion, pendiente probar con 0 ciclos (infinito). Ver detalle en Minutas 29/01/2022
2022-02-03 delay en tarea ADC frec muestreo
2022-02-03 limpieza de código, verificar funcionamiento
2022-02-05 se agrega clock para debug en qt
2022-02-05 optimizar refresco de datos => ahora es de forma parcial
2022-02-05 agrego fuente partida V1
    [Fuente_partida.kicad_pcb, Fuente_partida.sch, LPC.sch, potenciostato.sch, salida_dac.sch]
2022-02-06 emprolijar codigo, corregir bugs, codigo casi estable probado con n ciclos y con 0 ciclos
    [hid_generic.c, main.c, mainwindow.cpp]
2022-02-08 optimizar envio de datos para mandar mas de un punto por envio
2022-02-15 no resetea zoom gráfico
    [mainwindow.cpp]
2022-02-15 modificar stack size en adc de 5 a 1
2022-02-18 mergeado fuente_partida al kicad_reducido
    [Fuente_partida.kicad_pcb, Fuente_partida.sch, LPC.sch, potenciostato.csv, potenciostato.kicad_pcb, potenciostato.sch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]
2022-02-20 delay por timer en adc
    [LPC.kicad_sch, potenciostato.kicad_pcb, potenciostato.kicad_sch, salida_dac.kicad_sch]
2022-02-20 aumentar a 21 bytes el envio, mas imposible, da hard fault
2022-02-21 unificar el envio corriente tension
2022-02-22 agregada la hoja de Fuente_partida al esquematico raiz
    [potenciostato.sch]
2022-02-24 agregar pdfs actualizados y achichar esquematico fuente para paper
    [Fuente_partida.sch, LPC.sch, potenciostato.sch, salida_dac.sch]
2022-02-26 agregar boton centrar y autocentrar al finalizar la medicion, preparar menu contextual para medir con cursores
2022-03-01 se cambia frec de muestreo ADC
2022-03-02 agregar exportarCSV y corregir set de rango al iniciar medicion
2022-03-12 agregar seniales 2000 muestras, 4000 y 8000 con frec minima 0,025Hz o periodo maximo 40 segundos
2022-03-13 diferenciar frecuencias paso 1 de 2, falta asignar distintos vectores de seniales a frec alta y frec baja
2022-03-13 generacion de muy bajas frecuencias
2022-03-17 tarea DAC y ADC creadas para cada medición
2022-03-21 reintento ante fallas dma, constante antes de generar señal
2022-03-29 se agrega nueva version de placa
    [LPC.kicad_sch, LPC.sch, fuente.kicad_sch, potenciostato.dsn, potenciostato_2.dsn, potenciostato_3.dsn, potenciostato_4.dsn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]
2022-05-15 comunicacion en LPCsegun protocolo v3 realizada, falta generar la señal
2022-05-28 generada la señal desde el LPC
2022-06-05 ultimo commit sin la señal generada con 3 puntos, los proximos commits seran sin DMA
2022-06-06 hecha la señal testeada y probada OK
2022-06-06 arreglado el flanco inicial de subida/bajada
    [main.c]
2022-06-12 Limpieza LPC: DMA y QT:definicion LINEAL
2022-06-12 Desarrollado período retención y solucion, indirectamente, al problema de refresco del ADC y QT
    [main.c]
2022-06-25 agregado selector de ganancia x1, x2, x5 y x10
2022-06-25 agregado selector de ganancia corregido, .gitignore y ui_mainwindow.h
2022-07-02 reemplazado el timer de la retencion por un vTaskDelay
2022-07-16 se ajustan R de simulacion
2022-08-07 emprolijando un poco el codigo
2022-08-11 agregar calibracion de corriente ajuste grueso
    [med_2022.03.17-12_02_10.csv, med_2022.03.17-12_05_54.csv, med_2022.08.10-23_45_42.csv, med_2022.08.11-00_32_39.csv]
2022-08-16 agregados graficos
    [med_2022.08.15-22_31_59.csv, med_2022.08.15-22_38_14.csv, med_2022.08.15-22_47_24.csv, med_2022.08.15-23_01_48.csv, med_2022.08.15-23_28_21.csv]
2022-08-16 agregadas mediciones varias
    [med_2022.08.16-11_16_04.csv, med_2022.08.16-12_13_17.csv, med_2022.08.16-12_49_07.csv, med_2022.08.16-13_06_58.csv, med_2022.08.16-13_22_24.csv, med_2022.08.16-13_47_44.csv, med_2022.08.16-14_24_09.csv, med_2022.08.16-15_03_28.csv]
2022-08-20 agregada medicioin tension y corriente
    [1k5_-1000mv_2022.08.20-17_17_06.csv, 1k5_-100mv_2022.08.20-17_00_57.csv, 1k5_-200mv_2022.08.20-17_03_51.csv, 1k5_-400mv_2022.08.20-17_13_13.csv, 1k5_-750mv_2022.08.20-17_14_39.csv, 1k5_1000mv_2022.08.20-16_58_55.csv, 1k5_100mv_2022.08.20-16_23_33.csv, 1k5_300mv_2022.08.20-16_51_19.csv]
2022-09-06 simulaciones y kicad para placa nueva
    [Fuente_partida.sch, LPC.kicad_sch, LPC.sch, fuente.kicad_sch, potenciostato.csv, potenciostato.kicad_pcb, potenciostato.kicad_sch, potenciostato.sch]
2022-09-07 se agrega 4316 y ganancia de corriente variable
    [potenciostato.sch, salida_dac.sch]
2022-09-17 A partir de la ultima juntada en la facu
    [10k_1000mv_2022.08.22-18_35_34.csv]
2022-09-19 modificado volante y agregado logo con pinguino transparente para favicon
    [med_2022.08.16-13_47_44.csv]
2022-09-22 qr y volantes para imprimir
2022-09-22 depurada carpeta obsoleta de debug en qt
2022-10-09 arreglado el filtro y agregadas nuevas mediciones 8/10
    [med_2022.09.28-16_22_10.csv, med_2022.09.28-16_30_00.csv, med_2022.09.28-17_18_29_solo_Ag_Cl.csv, med_2022.09.28-17_22_15.csv, med_2022.09.28-17_34_58.csv, med_2022.09.28-17_41_00.csv, med_2022.09.28-18_03_52.csv, med_2022.09.28-18_18_53.csv]
2022-10-16 agregado lo de Hernan y fixeado el kicad pcb
    [Fuente_partida.sch, LPC.sch, potenciostato.csv, potenciostato.kicad_pcb, potenciostato.sch, potenciostato_branch.kicad_pcb, salida_dac.sch]
2022-10-16 fix anterior
    [potenciostato.sch]
2022-10-16 actualizado pcb desde esquematico al poner Rs de 10k y actualizar sus valores en funcion a la placa ya hecha
    [potenciostato.kicad_pcb]
2022-10-22 agregados los csvs desde el 15/10 hasta hoy
    [med_2022.10.15-15_49_13.csv, med_2022.10.15-15_52_58.csv, med_2022.10.15-16_05_24.csv, med_2022.10.15-16_14_47.csv, med_2022.10.15-16_28_59.csv, med_2022.10.15-16_33_24.csv, med_2022.10.15-17_00_49.csv, med_2022.10.15-17_14_48.csv]
2022-10-27 casi resuelto el abort desde el LPC. falta bloquear boton desde QT
2022-10-28 build de qt por cambio de repo
2022-10-29 hecho esquematico en base a simulacion
    [potenciostato.kicad_pcb, potenciostato.sch, salida_dac.sch]
2022-10-29 actualizacion pcb desde esquematico nuevo
    [potenciostato.kicad_pcb]
2022-10-31 pin 7 de u9 a GND
    [salida_dac.sch]
2022-11-02 se agrega version simple fas del pcb
    [potenciostato_simple_faz.kicad_pcb, salida_dac.sch]
2022-11-06 trazando pcb
    [potenciostato.kicad_pcb, potenciostato.sch]
2022-11-06 trazado pcb
    [potenciostato.kicad_pcb]
2022-11-07 trazado casi listo
    [potenciostato.kicad_pcb]
2022-11-07 modificado SCH?
    [potenciostato.sch]
2022-11-07 agregadas vias
    [potenciostato.kicad_pcb, salida_dac.sch]
2022-11-08 puestos USBy trafo OK
    [potenciostato.kicad_pcb, potenciostato.sch, salida_dac.sch]
2022-11-09 modificaciones esteticas en el pcb y test_DAC por test_VIN
    [potenciostato.kicad_pcb, potenciostato.sch]
2022-11-10 planos de masa, gerber
    [potenciostato-B_Cu.gbr, potenciostato-B_Mask.gbr, potenciostato-B_Paste.gbr, potenciostato-B_SilkS.gbr, potenciostato-Edge_Cuts.gbr, potenciostato-F_Cu.gbr, potenciostato-F_Mask.gbr, potenciostato-F_Paste.gbr]
2022-11-10 movido USB
    [potenciostato.kicad_pcb]
2022-11-11 agregado logo potencio al b.silk, falta generar gerber y taladro de vuelta
    [logo_potencio.dxf, logo_potencio_kicad.dxf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]
2022-11-13 cambios esteticos en el silk
    [logo_potencio_kicad_invertido.dxf, logo_potencio_kicad_web.dxf, logo_potencio_kicad_web_invertida.dxf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]
2022-11-14 Se acomodó el F-silk
    [potenciostato.kicad_pcb]
2022-11-14 cambios esteticos en fsilk
    [potenciostato.kicad_pcb]
2022-11-14 finalizado (casi) f silk, falta mover BNC para que no choqeu con LPC
    [potenciostato.sch, salida_dac.sch]
2022-11-14 falta mover BNC
    [potenciostato.kicad_pcb]
2022-11-14 pusheo de vuelta.... falta mover bnv
2022-11-14 cambios huellas bornera y lpc
    [potenciostato.sch]
2022-11-14 version final?
    [potenciostato-B_Cu.gbr, potenciostato-B_Mask.gbr, potenciostato-B_Paste.gbr, potenciostato-B_SilkS.gbr, potenciostato-Dwgs_User.gbr, potenciostato-F_Cu.gbr, potenciostato-F_Mask.gbr, potenciostato-F_Paste.gbr]
2022-11-16 mandado a hacer a jlcpcb.com
    [potenciostato-B_Cu.gbr, potenciostato-B_Mask.gbr, potenciostato-B_SilkS.gbr, potenciostato-Dwgs_User.gbr, potenciostato-Edge_Cuts.gbr, potenciostato-F_Cu.gbr, potenciostato-F_Mask.gbr, potenciostato-F_SilkS.gbr]
2022-12-07 version mandada a hacer a jlcpcb
    [potenciostato.kicad_pcb]
2022-12-13 nuevos puertos switch de ganancia
2022-12-14 ultima medicion en el lab
    [med_2022.12.14-18_00_48.csv, med_2022.12.14-18_03_49.csv, med_2022.12.14-18_06_12.csv, med_2022.12.14-18_09_59.csv, med_2022.12.14-18_13_06.csv, med_2022.12.14-18_18_16.csv, med_2022.12.14-18_26_06.csv]
2022-12-21 calibracion placa v2 (alias v3) x1, falta x0.1
    [med_2022.12.14-18_26_06_recalibrado_x1.csv]
2022-12-22 agregado calibracion para x0.1, la unica que hay y el CSV x0.1 en base a la medicion en Quimica
    [med_2022.12.14-18_26_06_recalibrado_x0.1.csv]
2023-02-11 trazado pdf kicad
    [potenciostato.csv, potenciostato.kicad_pcb]
2023-02-11 se agrega titulo a esquematico
    [potenciostato.kicad_pcb, potenciostato.sch, salida_dac.sch]
2023-02-11 Limpieza al repo y agregados archivos accesorios para el entrega final
    [LPC.sch, potenciostato.csv, potenciostato.kicad_pcb, potenciostato.sch, potenciostato_branch.kicad_pcb, salida_dac.sch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]
2023-02-18 Se agregaron el informe y el anexo completo
